mkinderwater/mk-piclock-kid/(list of files, cad)

Other CAD files:
mk-piclock-kids-v3_47-recess-roof-fix-6.scad
