mkinderwater/mk-piclock-kid/mk-piclock.c

/*
  mk-piclock.c

  Private Raspberry Pi alarm clock core daemon.

  Features:
    - SSD1322 256x64 OLED over /dev/spidev0.0
    - libgpiod GPIO for OLED DC/RST and TTP223B touch input
    - Private Unix socket control service for mk-piclock-api
    - MP3 playback using libmpg123 + ALSA PCM
    - Alarms, fonts, images, messages, bedtime dimming, touch input, and config

  Build both services with the supplied Makefile.
*/

#define _GNU_SOURCE

#include <ctype.h>
#include <errno.h>
#include <dirent.h>
#include <fcntl.h>
#include <arpa/inet.h>
#include <net/if.h>
#include <linux/wireless.h>
#include <linux/spi/spidev.h>
#include <poll.h>
#include <pwd.h>
#include <alsa/asoundlib.h>
#include <mpg123.h>
#include <pthread.h>
#include <signal.h>
#include <stdarg.h>
#include <stdint.h>
#include <stdio.h>
#include <stdlib.h>
#include <string.h>
#include <sys/ioctl.h>
#include <sys/socket.h>
#include <sys/stat.h>
#include <sys/types.h>
#include <sys/un.h>
#include <time.h>
#include <unistd.h>

#include <ft2build.h>
#include FT_FREETYPE_H

#include <gpiod.h>

#include "hardware_profile.h"
#include "ipc_protocol.h"
#include "led_control.h"
#include "asset_format.h"
#include "font_catalog.h"
#include "util.h"

#define safe_str mp_safe_str
#define write_all mp_write_full

#define APP_NAME "mk-piclock-core"
#define APP_VERSION MP_PRODUCT_VERSION

#define LED_PROFILE(fx, level, seconds, r1, g1, b1, r2, g2, b2) \
    { .effect = (fx), .brightness = (level), .cycle_seconds = (seconds), .reserved = 0, \
      .red1 = (r1), .green1 = (g1), .blue1 = (b1), \
      .red2 = (r2), .green2 = (g2), .blue2 = (b2) }
#define DEFAULT_CLOCK_NAME "Rylie"
#define STARTUP_GREETING_SECONDS 3
#define APP_ROOT "/opt/mk-piclock"
#define IMAGE_DIR APP_ROOT "/assets/images"
#define BEDTIME_IMAGE_DIR APP_ROOT "/assets/bedtime-images"
#define MUSIC_DIR APP_ROOT "/assets/music"
#define STORY_DIR APP_ROOT "/assets/stories"
#define DEFAULT_ALARM_PATH APP_ROOT "/assets/default-alarm.mp3"
#define DEFAULT_ALARM_LABEL "Built-in Alarm"
#define MESSAGE_CHIME_PATH APP_ROOT "/assets/message-chime.mp3"
#define MESSAGE_CHIME_LABEL "Message Chime"
#define MESSAGE_CHIME_VOLUME_MAX 55
#define ALARM_MAX_DURATION_SECONDS 1800
#define FONT_DIR APP_ROOT "/assets/fonts"
#define SYSTEM_DEFAULT_FONT_ID 4
#define LEGACY_SYSTEM_DEFAULT_FONT_KEY "system-dejavu-sans-mono"
#define SYSTEM_DEFAULT_FONT_PATH "/usr/share/fonts/truetype/dejavu/DejaVuSansMono.ttf"
#define CONFIG_DIR APP_ROOT "/config"
#define CONFIG_FILE CONFIG_DIR "/clock.conf"
#define LOG_FILE CONFIG_DIR "/event.log"
#define LOG_MAX_BYTES 65536
#define LOG_KEEP_BYTES 32768
#define LOG_VIEW_LINES 200


#define OLED_SPI_DEV "/dev/spidev0.0"
#define OLED_W 256
#define OLED_H 64
#define OLED_ROW_BYTES (OLED_W / 2)
#define OLED_FB_BYTES ((OLED_W * OLED_H) / 2)
#define OLED_EDGE_PADDING 2
#define SPI_SPEED_HZ 4000000
#define SPI_CHUNK 4096

#define MESSAGE_IMAGE_X OLED_EDGE_PADDING
#define MESSAGE_IMAGE_Y 8
#define MESSAGE_IMAGE_WIDTH 96
#define MESSAGE_IMAGE_HEIGHT 48
#define MESSAGE_IMAGE_TEXT_GAP 8
#define MESSAGE_TEXT_RIGHT_PADDING 6
#define MESSAGE_TEXT_X (MESSAGE_IMAGE_X + MESSAGE_IMAGE_WIDTH + MESSAGE_IMAGE_TEXT_GAP)
#define MESSAGE_TEXT_Y 8
#define MESSAGE_TEXT_W (OLED_W - MESSAGE_TEXT_X - MESSAGE_TEXT_RIGHT_PADDING)
#define MESSAGE_TEXT_H 48
#define MESSAGE_MAX_LINES 3
#define MESSAGE_LINE_CHARS 64
#define MESSAGE_INPUT_MAX_CHARS 180
#define MESSAGE_FALLBACK_SCALE 1
#define MESSAGE_TTF_MIN_PX 9
#define MESSAGE_TTF_MAX_PX 12
#define MESSAGE_DEFAULT_DURATION_SECONDS 30
#define MESSAGE_DELAY_MAX_SECONDS 60


#define GPIO_CHIP "/dev/gpiochip0"
#define GPIO_DC 25
#define GPIO_RST 27
#define GPIO_TOUCH 20
#define TOUCH_POLL_MS 20u
#define TOUCH_DEBOUNCE_MS 50u
#define TOUCH_LONG_PRESS_MS 3000u
#define TOUCH_DIAGNOSTIC_PRESS_MS 8000u
#define DIAGNOSTIC_SCREEN_SECONDS 30u
#define DIAGNOSTIC_REFRESH_MS 2000u
#define STORY_PRESS_COUNT 10
#define STORY_PRESS_WINDOW_MS 8000u
#define STORY_MESSAGE_MAX 64
#define STORY_COLLAGE_MAX_IMAGES 5
#define STORY_COLLAGE_IMAGE_SIZE 48
#define STORY_INTRO_SECONDS 3u
#define STORY_TITLE_SECONDS 4u

#define MAX_ALARMS 7
#define MUSIC_FILE_MAX 256
#define IMAGE_FILE_MAX 128
#define CLOCK_IMAGE_CHANGE_MAX_SECONDS 300
#define BEDTIME_IMAGE_CHANGE_SECONDS 300
#define CLOCK_TIME_Y_OFFSET -7
#define CLOCK_FOOTER_H 11
#define CLOCK_FOOTER_TEXT_Y (OLED_H - 9)
#define CLOCK_EDGE_PADDING OLED_EDGE_PADDING
#define CLOCK_CONTENT_RIGHT_PIXEL (OLED_W - CLOCK_EDGE_PADDING - 1)
#define CLOCK_SECONDS_LINE_Y (OLED_H - CLOCK_FOOTER_H - 1)
#define CLOCK_SECONDS_LINE_LEVEL 12
#define CLOCK_STATUS_TEXT_X CLOCK_EDGE_PADDING
#define CLOCK_IMAGE_X CLOCK_STATUS_TEXT_X
#define CLOCK_IMAGE_Y CLOCK_EDGE_PADDING
#define CLOCK_IMAGE_MAX_WIDTH 96
#define CLOCK_IMAGE_BOTTOM_PIXEL (CLOCK_SECONDS_LINE_Y - CLOCK_EDGE_PADDING - 1)
#define CLOCK_IMAGE_HEIGHT (CLOCK_IMAGE_BOTTOM_PIXEL - CLOCK_IMAGE_Y + 1)
#define CLOCK_IMAGE_FONT_GAP CLOCK_EDGE_PADDING
#define CLOCK_STATUS_CONTENT_GAP 7
#define SONG_METADATA_TEXT_MAX (MP_ID3_TEXT_MAX * 2 + 4)
#define SONG_SCROLL_SPEED_PX_PER_SEC 18u
#define SONG_SCROLL_GAP_PX 24
#define SONG_SCROLL_FRAME_US 75000u

#if CLOCK_STATUS_TEXT_X != CLOCK_EDGE_PADDING
#error "Alarm footer left padding must use CLOCK_EDGE_PADDING"
#endif
#if CLOCK_IMAGE_X != CLOCK_STATUS_TEXT_X
#error "Clock artwork and ALARM text must share the same left pixel"
#endif
#if MESSAGE_IMAGE_X != CLOCK_STATUS_TEXT_X
#error "Message artwork and ALARM text must share the same left pixel"
#endif
#if MESSAGE_IMAGE_X != CLOCK_IMAGE_X || MESSAGE_IMAGE_Y != 8
#error "Message artwork must preserve X=2 alignment and Y=8 placement"
#endif
#if MESSAGE_IMAGE_WIDTH != CLOCK_IMAGE_MAX_WIDTH || MESSAGE_IMAGE_HEIGHT != CLOCK_IMAGE_HEIGHT
#error "Message artwork must preserve the normal 96x48 clock image viewport"
#endif
#if MESSAGE_TEXT_X != 106 || MESSAGE_TEXT_Y != 8 || MESSAGE_TEXT_W != 144 || MESSAGE_TEXT_H != 48
#error "Message text viewport must remain 144x48 at X=106, Y=8"
#endif
#if MESSAGE_TTF_MIN_PX != 9 || MESSAGE_TTF_MAX_PX != 12 || MESSAGE_FALLBACK_SCALE != 1
#error "Message typography must remain independent and compact"
#endif


#define CORE_RUNTIME_DIR "/run/mk-piclock"
#define CORE_SOCKET_PATH CORE_RUNTIME_DIR "/core.sock"
#define ASSET_LIST_MAX_FILES 256
#define ASSET_LIST_NAME_MAX MUSIC_FILE_MAX

static volatile sig_atomic_t g_running = 1;
static time_t g_start_time = 0;
static pthread_mutex_t g_log_lock = PTHREAD_MUTEX_INITIALIZER;
static char g_footer_alarm_label[32] = "";
static int g_footer_content_min_x = CLOCK_STATUS_TEXT_X;

struct clock_tick_cache {
    uint8_t colon_off_fb[OLED_FB_BYTES];
    uint8_t colon_on_fb[OLED_FB_BYTES];
    int valid;
};

static struct clock_tick_cache g_clock_tick_cache = {
    .valid = 0
};

struct rotating_image_state {
    char file[IMAGE_FILE_MAX];
    time_t next_change;
};

static struct rotating_image_state g_rotating_images[2];

struct story_collage_state {
    char files[STORY_COLLAGE_MAX_IMAGES][IMAGE_FILE_MAX];
    int count;
};

static struct story_collage_state g_story_collage;

struct image_raw_cache {
    char file[IMAGE_FILE_MAX];
    int bedtime;
    uint8_t raw[MP_IMAGE_RAW_BYTES];
    int valid;
    unsigned long generation;
};

static pthread_mutex_t g_image_raw_cache_lock = PTHREAD_MUTEX_INITIALIZER;
static struct image_raw_cache g_image_raw_cache = { .file = "", .bedtime = 0, .valid = 0, .generation = 0 };

struct alarm_slot {
    int enabled;
    int hour;
    int min;
    int weekdays;          /* bit 0 Sunday through bit 6 Saturday */
    int start_volume;      /* 0..100 */
    int end_volume;        /* 0..100 */
    int last_fired_date;   /* local YYYYMMDD, persisted before playback starts */
    char music_file[MUSIC_FILE_MAX]; /* empty = random uploaded MP3 */
};

static time_t next_alarm_time(const struct alarm_slot alarms[MAX_ALARMS], time_t now,
                              int *alarm_id);

struct app_state {
    int display_mode;       /* 0 clock, 1 clear, 2 message, 3 diagnostics */
    int display_dirty;      /* set by API IPC thread; drawn by main OLED loop */
    int diagnostic_return_mode;
    time_t diagnostic_until;
    char message_image_file[IMAGE_FILE_MAX];
    int message_image_bedtime;
    time_t message_until;   /* unix time; 0 = no active message */
    char message_text[192];
    char pending_message_image_file[IMAGE_FILE_MAX];
    int pending_message_image_bedtime;
    int pending_message_notification_sound;
    char pending_message_text[192];
    time_t pending_message_at;
    int global_volume;
    int story_mode_enabled;
    int story_volume;
    char story_message[STORY_MESSAGE_MAX];
    int story_playing;
    uint64_t story_intro_until_ms;
    uint64_t story_title_until_ms;
    int bedtime_enabled;
    int bedtime_start_hour;
    int bedtime_start_min;
    int bedtime_end_hour;
    int bedtime_end_min;
    int bedtime_dim_percent;
    int bedtime_music_enabled;
    int oled_contrast_current;
    int oled_master_current;
    int oled_brightness_current;
    int brightness_preview_percent;
    time_t brightness_preview_until;
    int audio_playing;
    char audio_file[MUSIC_FILE_MAX];
    char audio_title[MP_ID3_TEXT_MAX];
    char audio_artist[MP_ID3_TEXT_MAX];
    char audio_display[SONG_METADATA_TEXT_MAX];
    uint64_t audio_scroll_started_ms;
    int show_song_metadata;
    int alarm_active;             /* 1 only while an alarm MP3 is currently playing */
    int alarm_volume_percent;     /* current alarm ramp volume, 0..100 */
    long long last_successful_alarm;
    int alarm_replay_guard_migrated;
    struct alarm_slot alarms[MAX_ALARMS];
    struct mp_led_profile led_profiles[MP_LED_SCENE_COUNT];
    struct mp_led_global_settings led_settings;
    int led_bedtime_fade_active;
    int led_preview_scene;
    time_t led_preview_until;
    int led_preview_bypass_master;
    int led_preview_raw_output;
    struct mp_led_profile led_preview_profile;
    int oled_ok;
    char clock_name[64];
    int oled_font;         /* 0 seven, 1 seven thin, 2 pixel, 3 pixel bold, 4 Linux default */
    char oled_font_file[128]; /* uploaded filename or system font key, empty = built-in */
    int oled_font_size;    /* TrueType pixel size */
    int clock_24h_mode;    /* 0 = 12-hour, 1 = 24-hour */
    int oled_color;        /* GUI panel colour: yellow, green, or white */
    pthread_mutex_t lock;
};

static struct app_state g_state = {
    .display_mode = 0,
    .display_dirty = 1,
    .diagnostic_return_mode = 0,
    .diagnostic_until = 0,
    .message_image_file = "",
    .message_image_bedtime = 0,
    .message_until = 0,
    .message_text = "",
    .pending_message_image_file = "",
    .pending_message_image_bedtime = 0,
    .pending_message_notification_sound = 0,
    .pending_message_text = "",
    .pending_message_at = 0,
    .global_volume = 80,
    .story_mode_enabled = 0,
    .story_volume = 55,
    .story_message = "STORY MODE!",
    .story_playing = 0,
    .story_intro_until_ms = 0,
    .story_title_until_ms = 0,
    .bedtime_enabled = 0,
    .bedtime_start_hour = 21,
    .bedtime_start_min = 0,
    .bedtime_end_hour = 7,
    .bedtime_end_min = 0,
    .bedtime_dim_percent = 35,
    .bedtime_music_enabled = 1,
    .oled_contrast_current = -1,
    .oled_master_current = -1,
    .oled_brightness_current = -1,
    .brightness_preview_percent = -1,
    .brightness_preview_until = 0,
    .audio_playing = 0,
    .audio_file = "",
    .audio_title = "",
    .audio_artist = "",
    .audio_display = "",
    .audio_scroll_started_ms = 0,
    .show_song_metadata = 1,
    .alarm_active = 0,
    .alarm_volume_percent = 0,
    .last_successful_alarm = 0,
    .alarm_replay_guard_migrated = 0,
    .led_profiles = {
        [MP_LED_SCENE_ALARM] = LED_PROFILE(MP_LED_EFFECT_FADE, 70, 8, 255, 0, 0, 255, 160, 0),
        [MP_LED_SCENE_BEDTIME] = LED_PROFILE(MP_LED_EFFECT_SOLID, 3, 8, 255, 48, 0, 255, 48, 0),
        [MP_LED_SCENE_MESSAGE] = LED_PROFILE(MP_LED_EFFECT_FADE, 35, 8, 0, 150, 255, 255, 255, 255),
        [MP_LED_SCENE_MUSIC] = LED_PROFILE(MP_LED_EFFECT_RAINBOW, 40, 12, 255, 0, 0, 0, 0, 255),
        [MP_LED_SCENE_DAYTIME] = LED_PROFILE(MP_LED_EFFECT_SOLID, 5, 8, 255, 220, 160, 255, 220, 160),
        [MP_LED_SCENE_STORIES] = LED_PROFILE(MP_LED_EFFECT_FADE, 15, 8, 125, 45, 255, 0, 90, 255),
        [MP_LED_SCENE_TOUCH] = LED_PROFILE(MP_LED_EFFECT_FADE, 60, 2, 255, 255, 255, 0, 0, 0)
    },
    .led_settings = {1, 100, 100, 65, 80, 0, 15, 1, 60, 255, 255, 255},
    .led_bedtime_fade_active = 0,
    .led_preview_scene = -1,
    .led_preview_until = 0,
    .led_preview_bypass_master = 0,
    .led_preview_raw_output = 0,
    .led_preview_profile = {0},
    .oled_ok = 0,
    .clock_name = DEFAULT_CLOCK_NAME,
    .oled_font = SYSTEM_DEFAULT_FONT_ID,
    .oled_font_file = "",
    .oled_font_size = 48,
    .clock_24h_mode = 0,
    .oled_color = MP_OLED_COLOR_GREEN,
    .lock = PTHREAD_MUTEX_INITIALIZER
};

struct font_cache_state {
    pthread_mutex_t lock;
    FT_Library library;
    FT_Face face;
    char loaded_file[128];
    int loaded_size;
};

static struct font_cache_state g_font = {
    .lock = PTHREAD_MUTEX_INITIALIZER,
    .library = NULL,
    .face = NULL,
    .loaded_file = "",
    .loaded_size = 0
};

struct audio_player_state {
    pthread_mutex_t lock;
    pthread_cond_t stopped;
    int running;
    int stop_requested;
    int alarm_mode;
    int notification_mode;
    int timed_out;
    uint64_t alarm_deadline_ms;
    char file[MUSIC_FILE_MAX];
};

static struct audio_player_state g_audio = {
    .lock = PTHREAD_MUTEX_INITIALIZER,
    .stopped = PTHREAD_COND_INITIALIZER,
    .running = 0,
    .stop_requested = 0,
    .alarm_mode = 0,
    .notification_mode = 0,
    .timed_out = 0,
    .alarm_deadline_ms = 0,
    .file = ""
};


struct oled_dev {
    int spi_fd;
    struct gpiod_chip *chip;
    struct gpiod_line_request *gpio_req;
    uint8_t fb[OLED_FB_BYTES];
    uint8_t prev_fb[OLED_FB_BYTES];
    uint8_t preview_fb[OLED_FB_BYTES];
    pthread_mutex_t preview_lock;
    int prev_valid;
};

static struct oled_dev g_oled = {
    .spi_fd = -1,
    .chip = NULL,
    .gpio_req = NULL,
    .preview_lock = PTHREAD_MUTEX_INITIALIZER,
    .prev_valid = 0
};

/* Drawing normally targets the physical OLED framebuffer. The message editor
 * can render into a thread-local scratch framebuffer so its browser preview is
 * produced by the exact same renderer without changing the physical screen. */
static _Thread_local uint8_t *g_oled_render_fb = NULL;

static uint8_t *oled_draw_fb(void) {
    return g_oled_render_fb ? g_oled_render_fb : g_oled.fb;
}

struct touch_dev {
    struct gpiod_chip *chip;
    struct gpiod_line_request *request;
    pthread_mutex_t lock;
    int ready;
    int pressed;
};

static struct touch_dev g_touch = {
    .chip = NULL,
    .request = NULL,
    .lock = PTHREAD_MUTEX_INITIALIZER,
    .ready = 0,
    .pressed = 0
};

static void touch_get_state(int *ready, int *pressed);

static void on_signal(int sig) {
    (void)sig;
    g_running = 0;
}

static int ensure_dir(const char *path) {
    char tmp[512];
    snprintf(tmp, sizeof(tmp), "%s", path);
    size_t len = strlen(tmp);
    if (len == 0) return -1;
    if (tmp[len - 1] == '/') tmp[len - 1] = '\0';

    for (char *p = tmp + 1; *p; p++) {
        if (*p == '/') {
            *p = '\0';
            mkdir(tmp, 0755);
            *p = '/';
        }
    }
    if (mkdir(tmp, 0755) != 0 && errno != EEXIST) return -1;
    return 0;
}

static int hex_value(char ch) {
    if (ch >= '0' && ch <= '9') return ch - '0';
    if (ch >= 'a' && ch <= 'f') return ch - 'a' + 10;
    if (ch >= 'A' && ch <= 'F') return ch - 'A' + 10;
    return -1;
}

static void config_encode_to_buffer(char *out, size_t out_len, const char *in) {
    static const char hex[] = "0123456789ABCDEF";
    if (!out || out_len == 0) return;
    out[0] = '\0';
    if (!in) in = "";

    size_t j = 0;
    for (const unsigned char *p = (const unsigned char *)in; *p && j + 1 < out_len; p++) {
        unsigned char ch = *p;
        int plain = isalnum(ch) || ch == '.' || ch == '_' || ch == '-';
        if (plain) {
            out[j++] = (char)ch;
        } else {
            if (j + 3 >= out_len) break;
            out[j++] = '%';
            out[j++] = hex[(ch >> 4) & 0x0F];
            out[j++] = hex[ch & 0x0F];
        }
    }
    out[j] = '\0';
}

static void config_decode_inplace(char *s) {
    if (!s) return;
    char *o = s;
    for (char *p = s; *p; p++) {
        if (*p == '%' && p[1] && p[2]) {
            int hi = hex_value(p[1]);
            int lo = hex_value(p[2]);
            if (hi >= 0 && lo >= 0) {
                *o++ = (char)((hi << 4) | lo);
                p += 2;
                continue;
            }
        }
        *o++ = *p;
    }
    *o = '\0';
}

static void log_trim_if_needed_locked(void) {
    struct stat st;
    if (stat(LOG_FILE, &st) != 0 || st.st_size <= LOG_MAX_BYTES) return;

    FILE *in = fopen(LOG_FILE, "rb");
    if (!in) return;

    long keep = LOG_KEEP_BYTES;
    if (st.st_size < keep) keep = (long)st.st_size;
    if (fseek(in, -keep, SEEK_END) != 0) {
        fclose(in);
        return;
    }

    char *buf = (char *)malloc((size_t)keep + 1);
    if (!buf) {
        fclose(in);
        return;
    }

    size_t got = fread(buf, 1, (size_t)keep, in);
    fclose(in);
    buf[got] = '\0';

    char *start = buf;
    if (got == (size_t)keep && st.st_size > keep) {
        char *nl = strchr(buf, '\n');
        if (nl && nl[1]) start = nl + 1;
    }

    char tmp_path[512];
    snprintf(tmp_path, sizeof(tmp_path), "%s.tmp", LOG_FILE);
    FILE *out = fopen(tmp_path, "wb");
    if (out) {
        fwrite(start, 1, strlen(start), out);
        fclose(out);
        rename(tmp_path, LOG_FILE);
    }
    free(buf);
}

static void app_log(const char *category, const char *fmt, ...) {
    char msg[512];
    va_list ap;
    va_start(ap, fmt);
    vsnprintf(msg, sizeof(msg), fmt, ap);
    va_end(ap);

    for (char *p = msg; *p; p++) {
        if (*p == '\r' || *p == '\n' || *p == '\t') *p = ' ';
    }

    time_t now = time(NULL);
    struct tm tmv;
    localtime_r(&now, &tmv);
    char ts[32];
    strftime(ts, sizeof(ts), "%Y-%m-%d %H:%M:%S", &tmv);

    pthread_mutex_lock(&g_log_lock);
    ensure_dir(CONFIG_DIR);
    log_trim_if_needed_locked();

    FILE *f = fopen(LOG_FILE, "a");
    if (f) {
        fprintf(f, "%s [%s] %s\n", ts, category && *category ? category : "info", msg);
        fclose(f);
    }
    pthread_mutex_unlock(&g_log_lock);
}

static void sanitize_clock_name(char *s) {
    if (!s) return;

    char out[64];
    size_t j = 0;
    int last_space = 1;

    for (const unsigned char *p = (const unsigned char *)s; *p && j + 1 < sizeof(out); p++) {
        unsigned char ch = *p;
        if (ch == '\r' || ch == '\n' || ch == '\t') ch = ' ';
        if (ch < 32 || ch > 126) continue;
        if (ch == '<' || ch == '>' || ch == '&' || ch == '"') continue;
        if (ch == ' ') {
            if (last_space) continue;
            last_space = 1;
        } else {
            last_space = 0;
        }
        out[j++] = (char)ch;
    }

    while (j > 0 && out[j - 1] == ' ') j--;
    out[j] = '\0';

    if (!out[0]) snprintf(out, sizeof(out), "%s", DEFAULT_CLOCK_NAME);
    safe_str(s, 64, out);
}

static int safe_asset_filename(const char *name);
static void sanitize_message_text(char *s, size_t s_len);


static int has_raw_ext(const char *name) {
    const char *dot = strrchr(name ? name : "", '.');
    return dot && strcasecmp(dot, ".raw") == 0;
}

static int safe_image_filename(const char *name) {
    return safe_asset_filename(name) && has_raw_ext(name);
}

static const char *image_dir(int bedtime) {
    return bedtime ? BEDTIME_IMAGE_DIR : IMAGE_DIR;
}

static int make_image_path_by_file(const char *file, int bedtime, char *out, size_t out_len) {
    if (!out || out_len == 0) return -1;
    out[0] = '\0';
    if (!safe_image_filename(file)) return -1;
    int written = snprintf(out, out_len, "%s/%s", image_dir(bedtime), file);
    return written > 0 && (size_t)written < out_len ? 0 : -1;
}

static int has_font_ext(const char *name) {
    const char *dot = strrchr(name ? name : "", '.');
    if (!dot) return 0;
    return strcasecmp(dot, ".ttf") == 0 || strcasecmp(dot, ".otf") == 0;
}

static int safe_asset_filename(const char *name) {
    if (!name || !*name || strlen(name) >= 120) return 0;
    if (strcmp(name, ".") == 0 || strcmp(name, "..") == 0) return 0;
    for (const char *p = name; *p; p++) {
        unsigned char ch = (unsigned char)*p;
        if (!(isalnum(ch) || ch == '.' || ch == '_' || ch == '-')) return 0;
    }
    return 1;
}

static void make_font_path(const char *file, char *out, size_t out_len) {
    if (!out || out_len == 0) return;
    out[0] = '\0';
    if (file && strcmp(file, LEGACY_SYSTEM_DEFAULT_FONT_KEY) == 0) {
        safe_str(out, out_len, SYSTEM_DEFAULT_FONT_PATH);
        return;
    }
    if (mp_system_font_is_key(file)) {
        (void)mp_system_font_resolve(file, out, out_len);
        return;
    }
    snprintf(out, out_len, FONT_DIR "/%s", file && *file ? file : "");
}

static int clamp_int(int v, int lo, int hi) {
    if (v < lo) return lo;
    if (v > hi) return hi;
    return v;
}

static int local_date_key(const struct tm *tmv) {
    if (!tmv) return 0;
    int year = tmv->tm_year + 1900;
    int month = tmv->tm_mon + 1;
    if (year < 1970 || year > 9999 || month < 1 || month > 12 ||
        tmv->tm_mday < 1 || tmv->tm_mday > 31) return 0;
    return year * 10000 + month * 100 + tmv->tm_mday;
}

static int has_mp3_ext(const char *name) {
    if (!name) return 0;
    const char *dot = strrchr(name, '.');
    return dot && strcasecmp(dot, ".mp3") == 0;
}

static void make_music_path(const char *file, char *out, size_t out_len) {
    snprintf(out, out_len, MUSIC_DIR "/%s", file && *file ? file : "");
}


enum asset_list_kind {
    ASSET_LIST_IMAGE_RAW = 1,
    ASSET_LIST_MUSIC_MP3 = 2,
    ASSET_LIST_FONT = 3
};

static void invalidate_image_raw_cache(void) {
    pthread_mutex_lock(&g_image_raw_cache_lock);
    g_image_raw_cache.valid = 0;
    g_image_raw_cache.file[0] = '\0';
    g_image_raw_cache.generation++;
    pthread_mutex_unlock(&g_image_raw_cache_lock);
}

static void invalidate_image_assets(int bedtime) {
    invalidate_image_raw_cache();
    struct rotating_image_state *state = &g_rotating_images[bedtime ? 1 : 0];
    state->file[0] = '\0';
    state->next_change = 0;
}


static int asset_file_matches_kind(const char *dir, const char *name, int kind) {
    if (!dir || !name) return 0;
    if (kind == ASSET_LIST_IMAGE_RAW) {
        if (!safe_image_filename(name)) return 0;
        char path[512];
        snprintf(path, sizeof(path), "%s/%s", dir, name);
        struct stat st;
        return stat(path, &st) == 0 && MP_IMAGE_RAW_SIZE_VALID(st.st_size);
    }
    if (!safe_asset_filename(name)) return 0;
    if (kind == ASSET_LIST_MUSIC_MP3) return has_mp3_ext(name);
    if (kind == ASSET_LIST_FONT) return has_font_ext(name);
    return 0;
}

static int scan_asset_files(const char *dir, int kind, char files[][ASSET_LIST_NAME_MAX], int max_files) {
    if (!dir || !files || max_files <= 0) return 0;
    DIR *d = opendir(dir);
    if (!d) return 0;
    int count = 0;
    struct dirent *de;
    while ((de = readdir(d)) != NULL && count < max_files) {
        if (!asset_file_matches_kind(dir, de->d_name, kind)) continue;
        safe_str(files[count++], ASSET_LIST_NAME_MAX, de->d_name);
    }
    closedir(d);
    for (int i = 0; i < count; i++) {
        for (int j = i + 1; j < count; j++) {
            if (strcasecmp(files[i], files[j]) > 0) {
                char tmp[ASSET_LIST_NAME_MAX];
                safe_str(tmp, sizeof(tmp), files[i]);
                safe_str(files[i], ASSET_LIST_NAME_MAX, files[j]);
                safe_str(files[j], ASSET_LIST_NAME_MAX, tmp);
            }
        }
    }
    return count;
}

static int apply_default_font_selection(void) {
    char current[sizeof(g_state.oled_font_file)];
    int builtin;
    pthread_mutex_lock(&g_state.lock);
    safe_str(current, sizeof(current), g_state.oled_font_file);
    builtin = g_state.oled_font;
    pthread_mutex_unlock(&g_state.lock);

    int current_valid = 0;
    if (current[0] && strcmp(current, LEGACY_SYSTEM_DEFAULT_FONT_KEY) != 0) {
        char path[MP_SYSTEM_FONT_PATH_MAX];
        make_font_path(current, path, sizeof(path));
        current_valid = path[0] && access(path, R_OK) == 0;
    }
    if (current_valid || (!current[0] && builtin != SYSTEM_DEFAULT_FONT_ID)) return 0;

    char candidate[sizeof(g_state.oled_font_file)] = "";
    char files[ASSET_LIST_MAX_FILES][ASSET_LIST_NAME_MAX];
    int uploaded_count = scan_asset_files(FONT_DIR, ASSET_LIST_FONT, files, ASSET_LIST_MAX_FILES);
    if (uploaded_count > 0) {
        safe_str(candidate, sizeof(candidate), files[0]);
    } else {
        char system_path[MP_SYSTEM_FONT_PATH_MAX];
        (void)mp_system_font_find_filename("DejaVuSansMono.ttf", candidate, sizeof(candidate),
                                           system_path, sizeof(system_path));
    }

    int changed = 0;
    pthread_mutex_lock(&g_state.lock);
    if (strcmp(g_state.oled_font_file, current) == 0 && g_state.oled_font == builtin) {
        if (strcmp(g_state.oled_font_file, candidate) != 0 ||
            g_state.oled_font != SYSTEM_DEFAULT_FONT_ID) {
            safe_str(g_state.oled_font_file, sizeof(g_state.oled_font_file), candidate);
            g_state.oled_font = SYSTEM_DEFAULT_FONT_ID;
            g_state.display_dirty = 1;
            changed = 1;
        }
    }
    pthread_mutex_unlock(&g_state.lock);
    return changed;
}

static void init_alarm_defaults(void) {
    for (int i = 0; i < MAX_ALARMS; i++) {
        g_state.alarms[i].enabled = 0;
        g_state.alarms[i].hour = 7;
        g_state.alarms[i].min = 0;
        g_state.alarms[i].weekdays = 0x7F;
        g_state.alarms[i].start_volume = 20;
        g_state.alarms[i].end_volume = 80;
        g_state.alarms[i].last_fired_date = 0;
        g_state.alarms[i].music_file[0] = '\0';
    }
}


static void reset_persistent_state_locked(void) {
    g_state.display_mode = 0;
    g_state.display_dirty = 1;
    g_state.diagnostic_return_mode = 0;
    g_state.diagnostic_until = 0;
    g_state.message_image_file[0] = '\0';
    g_state.message_image_bedtime = 0;
    g_state.message_until = 0;
    g_state.message_text[0] = '\0';
    g_state.pending_message_image_file[0] = '\0';
    g_state.pending_message_image_bedtime = 0;
    g_state.pending_message_notification_sound = 0;
    g_state.pending_message_text[0] = '\0';
    g_state.pending_message_at = 0;
    g_state.global_volume = 80;
    g_state.story_mode_enabled = 0;
    g_state.story_volume = 55;
    safe_str(g_state.story_message, sizeof(g_state.story_message), "STORY MODE!");
    g_state.story_playing = 0;
    g_state.story_intro_until_ms = 0;
    g_state.story_title_until_ms = 0;
    g_state.bedtime_enabled = 0;
    g_state.bedtime_start_hour = 21;
    g_state.bedtime_start_min = 0;
    g_state.bedtime_end_hour = 7;
    g_state.bedtime_end_min = 0;
    g_state.bedtime_dim_percent = 35;
    g_state.bedtime_music_enabled = 1;
    g_state.show_song_metadata = 1;
    g_state.last_successful_alarm = 0;
    g_state.alarm_replay_guard_migrated = 1;
    safe_str(g_state.clock_name, sizeof(g_state.clock_name), DEFAULT_CLOCK_NAME);
    g_state.oled_font = SYSTEM_DEFAULT_FONT_ID;
    g_state.oled_font_file[0] = '\0';
    g_state.oled_font_size = 48;
    g_state.clock_24h_mode = 0;
    g_state.oled_color = MP_OLED_COLOR_GREEN;
    g_state.led_profiles[MP_LED_SCENE_ALARM] =
        (struct mp_led_profile)LED_PROFILE(MP_LED_EFFECT_FADE, 70, 8, 255, 0, 0, 255, 160, 0);
    g_state.led_profiles[MP_LED_SCENE_BEDTIME] =
        (struct mp_led_profile)LED_PROFILE(MP_LED_EFFECT_SOLID, 3, 8, 255, 48, 0, 255, 48, 0);
    g_state.led_profiles[MP_LED_SCENE_MESSAGE] =
        (struct mp_led_profile)LED_PROFILE(MP_LED_EFFECT_FADE, 35, 8, 0, 150, 255, 255, 255, 255);
    g_state.led_profiles[MP_LED_SCENE_MUSIC] =
        (struct mp_led_profile)LED_PROFILE(MP_LED_EFFECT_RAINBOW, 40, 12, 255, 0, 0, 0, 0, 255);
    g_state.led_profiles[MP_LED_SCENE_DAYTIME] =
        (struct mp_led_profile)LED_PROFILE(MP_LED_EFFECT_SOLID, 5, 8, 255, 220, 160, 255, 220, 160);
    g_state.led_profiles[MP_LED_SCENE_STORIES] =
        (struct mp_led_profile)LED_PROFILE(MP_LED_EFFECT_FADE, 15, 8, 125, 45, 255, 0, 90, 255);
    g_state.led_profiles[MP_LED_SCENE_TOUCH] =
        (struct mp_led_profile)LED_PROFILE(MP_LED_EFFECT_FADE, 60, 2, 255, 255, 255, 0, 0, 0);
    g_state.led_settings =
        (struct mp_led_global_settings){1, 100, 100, 65, 80, 0, 15, 1, 60, 255, 255, 255};
    g_state.led_bedtime_fade_active = 0;
    g_state.led_preview_scene = -1;
    g_state.led_preview_until = 0;
    g_state.led_preview_bypass_master = 0;
    g_state.led_preview_raw_output = 0;
    memset(&g_state.led_preview_profile, 0, sizeof(g_state.led_preview_profile));
    for (int i = 0; i < MAX_ALARMS; i++) {
        g_state.alarms[i].enabled = 0;
        g_state.alarms[i].hour = 7;
        g_state.alarms[i].min = 0;
        g_state.alarms[i].weekdays = 0x7F;
        g_state.alarms[i].start_volume = 20;
        g_state.alarms[i].end_volume = 80;
        g_state.alarms[i].last_fired_date = 0;
        g_state.alarms[i].music_file[0] = '\0';
    }
}


#define CONFIG_INT_FIELDS(X) \
    X("global_volume", g_state.global_volume, "%d") \
    X("story_mode_enabled", g_state.story_mode_enabled, "%d") \
    X("story_volume", g_state.story_volume, "%d") \
    X("show_song_metadata", g_state.show_song_metadata, "%d") \
    X("bedtime_enabled", g_state.bedtime_enabled, "%d") \
    X("bedtime_start_hour", g_state.bedtime_start_hour, "%02d") \
    X("bedtime_start_min", g_state.bedtime_start_min, "%02d") \
    X("bedtime_end_hour", g_state.bedtime_end_hour, "%02d") \
    X("bedtime_end_min", g_state.bedtime_end_min, "%02d") \
    X("bedtime_dim_percent", g_state.bedtime_dim_percent, "%d") \
    X("bedtime_music_enabled", g_state.bedtime_music_enabled, "%d") \
    X("oled_font", g_state.oled_font, "%d") \
    X("oled_font_size", g_state.oled_font_size, "%d") \
    X("clock_24h_mode", g_state.clock_24h_mode, "%d") \
    X("oled_color", g_state.oled_color, "%d") \
    X("alarm_replay_guard_migrated", g_state.alarm_replay_guard_migrated, "%d") \
    X("led_enabled", g_state.led_settings.enabled, "%d") \
    X("led_max_brightness", g_state.led_settings.max_brightness, "%d") \
    X("led_red_gain", g_state.led_settings.red_gain, "%d") \
    X("led_green_gain", g_state.led_settings.green_gain, "%d") \
    X("led_blue_gain", g_state.led_settings.blue_gain, "%d") \
    X("led_idle_off", g_state.led_settings.idle_off, "%d") \
    X("led_bedtime_fade_minutes", g_state.led_settings.bedtime_fade_minutes, "%d") \
    X("led_touch_blink_enabled", g_state.led_settings.touch_blink_enabled, "%d") \
    X("led_touch_blink_brightness", g_state.led_settings.touch_blink_brightness, "%d") \
    X("led_touch_blink_red", g_state.led_settings.touch_blink_red, "%d") \
    X("led_touch_blink_green", g_state.led_settings.touch_blink_green, "%d") \
    X("led_touch_blink_blue", g_state.led_settings.touch_blink_blue, "%d")

#define CONFIG_STRING_FIELDS(X) \
    X("clock_name", g_state.clock_name, sizeof(g_state.clock_name)) \
    X("story_message", g_state.story_message, sizeof(g_state.story_message)) \
    X("oled_font_file", g_state.oled_font_file, sizeof(g_state.oled_font_file))

#define CONFIG_ALARM_INT_FIELDS(X) \
    for (int i = 0; i < MAX_ALARMS; i++) { \
        X(i, "enabled", g_state.alarms[i].enabled, "%d", atoi(val) ? 1 : 0) \
        X(i, "hour", g_state.alarms[i].hour, "%02d", atoi(val)) \
        X(i, "min", g_state.alarms[i].min, "%02d", atoi(val)) \
        X(i, "weekdays", g_state.alarms[i].weekdays, "%d", atoi(val) & 0x7F) \
        X(i, "start_volume", g_state.alarms[i].start_volume, "%d", atoi(val)) \
        X(i, "end_volume", g_state.alarms[i].end_volume, "%d", atoi(val)) \
        X(i, "last_fired_date", g_state.alarms[i].last_fired_date, "%d", atoi(val)) \
    }

#define CONFIG_ALARM_STRING_FIELDS(X) \
    for (int i = 0; i < MAX_ALARMS; i++) { \
        X(i, "music_file", g_state.alarms[i].music_file, sizeof(g_state.alarms[i].music_file)) \
    }

static const char *led_scene_config_key(enum mp_led_scene scene) {
    switch (scene) {
        case MP_LED_SCENE_ALARM: return "alarm";
        case MP_LED_SCENE_BEDTIME: return "bedtime";
        case MP_LED_SCENE_MESSAGE: return "message";
        case MP_LED_SCENE_MUSIC: return "music";
        case MP_LED_SCENE_DAYTIME: return "daytime";
        case MP_LED_SCENE_STORIES: return "stories";
        case MP_LED_SCENE_TOUCH: return "touch";
        default: return "daytime";
    }
}

static void sanitize_led_profile(struct mp_led_profile *profile) {
    if (!profile) return;
    if (profile->effect > MP_LED_EFFECT_RAINBOW) profile->effect = MP_LED_EFFECT_SOLID;
    if (profile->brightness > 100) profile->brightness = 100;
    if (profile->cycle_seconds < 2) profile->cycle_seconds =
        profile->effect == MP_LED_EFFECT_RAINBOW ? 12 : 8;
    if (profile->cycle_seconds > 60) profile->cycle_seconds = 60;
    profile->reserved = 0;
}

static void sanitize_led_settings(struct mp_led_global_settings *settings) {
    if (!settings) return;
    settings->enabled = settings->enabled ? 1 : 0;
    if (settings->max_brightness > 100) settings->max_brightness = 100;
    if (settings->red_gain > 100) settings->red_gain = 100;
    if (settings->green_gain > 100) settings->green_gain = 100;
    if (settings->blue_gain > 100) settings->blue_gain = 100;
    settings->idle_off = settings->idle_off ? 1 : 0;
    if (settings->bedtime_fade_minutes > 120) settings->bedtime_fade_minutes = 120;
    settings->touch_blink_enabled = settings->touch_blink_enabled ? 1 : 0;
    if (settings->touch_blink_brightness > 100) settings->touch_blink_brightness = 100;
}

static int load_led_config_value(const char *key, const char *val) {
    char expected[96];
    for (int i = 0; i < MP_LED_SCENE_COUNT; i++) {
        struct mp_led_profile *profile = &g_state.led_profiles[i];
        const char *name = led_scene_config_key((enum mp_led_scene)i);
#define MATCH_LED_FIELD(suffix, target, maximum) \
        do { \
            snprintf(expected, sizeof(expected), "led_%s_%s", name, suffix); \
            if (strcmp(key, expected) == 0) { \
                target = (uint8_t)clamp_int(atoi(val), 0, maximum); \
                return 1; \
            } \
        } while (0)
        MATCH_LED_FIELD("effect", profile->effect, MP_LED_EFFECT_RAINBOW);
        MATCH_LED_FIELD("brightness", profile->brightness, 100);
        MATCH_LED_FIELD("cycle_seconds", profile->cycle_seconds, 60);
        MATCH_LED_FIELD("red1", profile->red1, 255);
        MATCH_LED_FIELD("green1", profile->green1, 255);
        MATCH_LED_FIELD("blue1", profile->blue1, 255);
        MATCH_LED_FIELD("red2", profile->red2, 255);
        MATCH_LED_FIELD("green2", profile->green2, 255);
        MATCH_LED_FIELD("blue2", profile->blue2, 255);
#undef MATCH_LED_FIELD
    }
    return 0;
}

static void save_config(void) {
    ensure_dir(CONFIG_DIR);

    char tmp_path[512];
    snprintf(tmp_path, sizeof(tmp_path), CONFIG_FILE ".tmp");

    FILE *f = fopen(tmp_path, "w");
    if (!f) return;

    pthread_mutex_lock(&g_state.lock);
#define SAVE_CONFIG_INT(cfg_key, field, fmt) fprintf(f, cfg_key "=" fmt "\n", field);
    CONFIG_INT_FIELDS(SAVE_CONFIG_INT)
#undef SAVE_CONFIG_INT
#define SAVE_CONFIG_ALARM_INT(idx, field_str, field, fmt, conversion) \
    fprintf(f, "alarm%d_%s=" fmt "\n", (idx) + 1, field_str, field);
    CONFIG_ALARM_INT_FIELDS(SAVE_CONFIG_ALARM_INT)
#undef SAVE_CONFIG_ALARM_INT
#define SAVE_CONFIG_ALARM_STRING(idx, field_str, field, field_size) \
    do { \
        char enc[(field_size) * 3]; \
        config_encode_to_buffer(enc, sizeof(enc), field); \
        fprintf(f, "alarm%d_%s=%s\n", (idx) + 1, field_str, enc); \
    } while (0);
    CONFIG_ALARM_STRING_FIELDS(SAVE_CONFIG_ALARM_STRING)
#undef SAVE_CONFIG_ALARM_STRING
#define SAVE_CONFIG_STRING(cfg_key, field, field_size) \
    do { \
        char enc[(field_size) * 3]; \
        config_encode_to_buffer(enc, sizeof(enc), field); \
        fprintf(f, cfg_key "=%s\n", enc); \
    } while (0);
    CONFIG_STRING_FIELDS(SAVE_CONFIG_STRING)
#undef SAVE_CONFIG_STRING
    for (int i = 0; i < MP_LED_SCENE_COUNT; i++) {
        const struct mp_led_profile *profile = &g_state.led_profiles[i];
        const char *name = led_scene_config_key((enum mp_led_scene)i);
        fprintf(f, "led_%s_effect=%u\n", name, profile->effect);
        fprintf(f, "led_%s_brightness=%u\n", name, profile->brightness);
        fprintf(f, "led_%s_cycle_seconds=%u\n", name, profile->cycle_seconds);
        fprintf(f, "led_%s_red1=%u\n", name, profile->red1);
        fprintf(f, "led_%s_green1=%u\n", name, profile->green1);
        fprintf(f, "led_%s_blue1=%u\n", name, profile->blue1);
        fprintf(f, "led_%s_red2=%u\n", name, profile->red2);
        fprintf(f, "led_%s_green2=%u\n", name, profile->green2);
        fprintf(f, "led_%s_blue2=%u\n", name, profile->blue2);
    }
    fprintf(f, "last_successful_alarm=%lld\n", g_state.last_successful_alarm);
    fprintf(f, "pending_message_at=%lld\n", (long long)g_state.pending_message_at);
    fprintf(f, "pending_message_image_bedtime=%d\n",
            g_state.pending_message_image_bedtime ? 1 : 0);
    fprintf(f, "pending_message_notification_sound=%d\n",
            g_state.pending_message_notification_sound ? 1 : 0);
    {
        char enc_image[sizeof(g_state.pending_message_image_file) * 3];
        char enc_text[sizeof(g_state.pending_message_text) * 3];
        config_encode_to_buffer(enc_image, sizeof(enc_image), g_state.pending_message_image_file);
        config_encode_to_buffer(enc_text, sizeof(enc_text), g_state.pending_message_text);
        fprintf(f, "pending_message_image_file=%s\n", enc_image);
        fprintf(f, "pending_message_text=%s\n", enc_text);
    }
    pthread_mutex_unlock(&g_state.lock);

    int ok = 1;
    if (fflush(f) != 0) ok = 0;
    if (ok && fsync(fileno(f)) != 0) ok = 0;
    if (fclose(f) != 0) ok = 0;

    if (ok) {
        if (rename(tmp_path, CONFIG_FILE) != 0) {
            unlink(tmp_path);
        } else {
            /* fsync the parent directory so the rename itself is durable before
               an alarm begins playing and power can be removed. */
            int dir_fd = open(CONFIG_DIR, O_RDONLY | O_DIRECTORY | O_CLOEXEC);
            if (dir_fd >= 0) {
                (void)fsync(dir_fd);
                close(dir_fd);
            }
        }
    } else {
        unlink(tmp_path);
    }
}

static void load_config(void) {
    FILE *f = fopen(CONFIG_FILE, "r");
    if (!f) return;

    char line[1024];
    while (fgets(line, sizeof(line), f)) {
        char *eq = strchr(line, '=');
        if (!eq) continue;
        *eq = '\0';
        char *key = line;
        char *val = eq + 1;
        val[strcspn(val, "\r\n")] = '\0';

        int matched = load_led_config_value(key, val);
        char tmp_key[128];
        if (!matched && strcmp(key, "last_successful_alarm") == 0) {
            char *end = NULL;
            errno = 0;
            long long parsed = strtoll(val, &end, 10);
            if (!errno && end != val && *end == '\0' && parsed > 0)
                g_state.last_successful_alarm = parsed;
            matched = 1;
        } else if (strcmp(key, "pending_message_at") == 0) {
            char *end = NULL;
            errno = 0;
            long long parsed = strtoll(val, &end, 10);
            if (!errno && end != val && *end == '\0' && parsed > 0)
                g_state.pending_message_at = (time_t)parsed;
            matched = 1;
        } else if (strcmp(key, "pending_message_image_bedtime") == 0) {
            g_state.pending_message_image_bedtime = atoi(val) ? 1 : 0;
            matched = 1;
        } else if (strcmp(key, "pending_message_notification_sound") == 0) {
            g_state.pending_message_notification_sound = atoi(val) ? 1 : 0;
            matched = 1;
        } else if (strcmp(key, "pending_message_image_file") == 0) {
            char decoded[384];
            safe_str(decoded, sizeof(decoded), val);
            config_decode_inplace(decoded);
            safe_str(g_state.pending_message_image_file, sizeof(g_state.pending_message_image_file), decoded);
            matched = 1;
        } else if (strcmp(key, "pending_message_text") == 0) {
            char decoded[768];
            safe_str(decoded, sizeof(decoded), val);
            config_decode_inplace(decoded);
            safe_str(g_state.pending_message_text, sizeof(g_state.pending_message_text), decoded);
            matched = 1;
        }
#define LOAD_CONFIG_ALARM_INT(idx, field_str, field, fmt, conversion) \
        do { \
            snprintf(tmp_key, sizeof(tmp_key), "alarm%d_%s", (idx) + 1, field_str); \
            if (!matched && strcmp(key, tmp_key) == 0) { \
                field = conversion; \
                matched = 1; \
            } \
        } while (0);
        CONFIG_ALARM_INT_FIELDS(LOAD_CONFIG_ALARM_INT)
#undef LOAD_CONFIG_ALARM_INT
#define LOAD_CONFIG_ALARM_STRING(idx, field_str, field, field_size) \
        do { \
            snprintf(tmp_key, sizeof(tmp_key), "alarm%d_%s", (idx) + 1, field_str); \
            if (!matched && strcmp(key, tmp_key) == 0) { \
                char dec[384]; \
                safe_str(dec, sizeof(dec), val); \
                config_decode_inplace(dec); \
                safe_str(field, field_size, dec); \
                matched = 1; \
            } \
        } while (0);
        CONFIG_ALARM_STRING_FIELDS(LOAD_CONFIG_ALARM_STRING)
#undef LOAD_CONFIG_ALARM_STRING

#define LOAD_CONFIG_INT(cfg_key, field, fmt) \
        do { \
            if (!matched && strcmp(key, cfg_key) == 0) { \
                field = atoi(val); \
                matched = 1; \
            } \
        } while (0);
        CONFIG_INT_FIELDS(LOAD_CONFIG_INT)
#undef LOAD_CONFIG_INT
#define LOAD_CONFIG_STRING(cfg_key, field, field_size) \
        do { \
            if (!matched && strcmp(key, cfg_key) == 0) { \
                char dec[384]; \
                safe_str(dec, sizeof(dec), val); \
                config_decode_inplace(dec); \
                safe_str(field, field_size, dec); \
                matched = 1; \
            } \
        } while (0);
        CONFIG_STRING_FIELDS(LOAD_CONFIG_STRING)
#undef LOAD_CONFIG_STRING
    }

    fclose(f);

    g_state.global_volume = clamp_int(g_state.global_volume, 0, 100);
    g_state.story_mode_enabled = g_state.story_mode_enabled ? 1 : 0;
    g_state.story_volume = clamp_int(g_state.story_volume, 0, 100);
    sanitize_message_text(g_state.story_message, sizeof(g_state.story_message));
    if (!g_state.story_message[0]) safe_str(g_state.story_message, sizeof(g_state.story_message), "STORY MODE!");
    g_state.show_song_metadata = g_state.show_song_metadata ? 1 : 0;
    g_state.bedtime_enabled = g_state.bedtime_enabled ? 1 : 0;
    g_state.bedtime_start_hour = clamp_int(g_state.bedtime_start_hour, 0, 23);
    g_state.bedtime_start_min = clamp_int(g_state.bedtime_start_min, 0, 59);
    g_state.bedtime_end_hour = clamp_int(g_state.bedtime_end_hour, 0, 23);
    g_state.bedtime_end_min = clamp_int(g_state.bedtime_end_min, 0, 59);
    g_state.bedtime_dim_percent = clamp_int(g_state.bedtime_dim_percent, 0, 100);
    g_state.bedtime_music_enabled = g_state.bedtime_music_enabled ? 1 : 0;
    if (g_state.last_successful_alarm < 0) g_state.last_successful_alarm = 0;
    g_state.alarm_replay_guard_migrated = g_state.alarm_replay_guard_migrated ? 1 : 0;
    g_state.clock_24h_mode = g_state.clock_24h_mode ? 1 : 0;
    g_state.oled_color = clamp_int(g_state.oled_color, MP_OLED_COLOR_YELLOW, MP_OLED_COLOR_WHITE);
    for (int i = 0; i < MP_LED_SCENE_COUNT; i++)
        sanitize_led_profile(&g_state.led_profiles[i]);
    sanitize_led_settings(&g_state.led_settings);

    for (int i = 0; i < MAX_ALARMS; i++) {
        struct alarm_slot *a = &g_state.alarms[i];
        a->enabled = a->enabled ? 1 : 0;
        a->hour = clamp_int(a->hour, 0, 23);
        a->min = clamp_int(a->min, 0, 59);
        a->weekdays &= 0x7F;
        if (a->weekdays == 0) a->weekdays = 0x7F;
        a->start_volume = clamp_int(a->start_volume, 0, 100);
        a->end_volume = clamp_int(a->end_volume, 0, 100);
        if (a->last_fired_date < 19700101 || a->last_fired_date > 99991231)
            a->last_fired_date = 0;
        if (a->music_file[0] && (!safe_asset_filename(a->music_file) || !has_mp3_ext(a->music_file))) {
            a->music_file[0] = '\0';
        }
    }

    time_t now = time(NULL);
    if (g_state.pending_message_at > now + (time_t)(30 * 24 * 60 * 60)) {
        g_state.pending_message_at = 0;
        g_state.pending_message_image_file[0] = '\0';
        g_state.pending_message_image_bedtime = 0;
        g_state.pending_message_notification_sound = 0;
        g_state.pending_message_text[0] = '\0';
    } else if (g_state.pending_message_at > 0) {
        g_state.pending_message_image_bedtime = g_state.pending_message_image_bedtime ? 1 : 0;
        g_state.pending_message_notification_sound = g_state.pending_message_notification_sound ? 1 : 0;
        int pending_image_ok = 0;
        if (safe_image_filename(g_state.pending_message_image_file)) {
            char pending_path[512];
            pending_image_ok = make_image_path_by_file(
                g_state.pending_message_image_file,
                g_state.pending_message_image_bedtime,
                pending_path, sizeof(pending_path)) == 0 &&
                access(pending_path, R_OK) == 0;
        }
        if (!pending_image_ok)
            g_state.pending_message_image_file[0] = '\0';
        sanitize_message_text(g_state.pending_message_text, sizeof(g_state.pending_message_text));
        if (!g_state.pending_message_text[0] && !pending_image_ok) {
            g_state.pending_message_at = 0;
            g_state.pending_message_image_bedtime = 0;
            g_state.pending_message_notification_sound = 0;
        }
    } else {
        g_state.pending_message_image_file[0] = '\0';
        g_state.pending_message_image_bedtime = 0;
        g_state.pending_message_notification_sound = 0;
        g_state.pending_message_text[0] = '\0';
    }

    sanitize_clock_name(g_state.clock_name);
    if (g_state.oled_font < 0 || g_state.oled_font > SYSTEM_DEFAULT_FONT_ID)
        g_state.oled_font = SYSTEM_DEFAULT_FONT_ID;
    if (g_state.oled_font_size < 18 || g_state.oled_font_size > 54) g_state.oled_font_size = 48;
}

static int migrate_alarm_last_fired_dates(void) {
    if (g_state.alarm_replay_guard_migrated) return 0;

    g_state.alarm_replay_guard_migrated = 1;
    if (g_state.last_successful_alarm <= 0) return 1;

    time_t last_alarm = (time_t)g_state.last_successful_alarm;
    struct tm alarm_tm;
    if (!localtime_r(&last_alarm, &alarm_tm)) return 1;

    int date_key = local_date_key(&alarm_tm);
    if (date_key == 0) return 1;

    pthread_mutex_lock(&g_state.lock);
    for (int i = 0; i < MAX_ALARMS; i++) {
        struct alarm_slot *a = &g_state.alarms[i];
        int weekday_ok = (a->weekdays & (1 << alarm_tm.tm_wday)) != 0;
        if (a->last_fired_date == 0 && weekday_ok &&
            a->hour == alarm_tm.tm_hour && a->min == alarm_tm.tm_min) {
            a->last_fired_date = date_key;
        }
    }
    pthread_mutex_unlock(&g_state.lock);
    return 1;
}

/* ---------------- OLED low level ---------------- */

static int gpio_set(unsigned int offset, int value) {
    if (!g_oled.gpio_req) return -1;
    return gpiod_line_request_set_value(
        g_oled.gpio_req,
        offset,
        value ? GPIOD_LINE_VALUE_ACTIVE : GPIOD_LINE_VALUE_INACTIVE
    );
}

static int spi_write_bytes(const uint8_t *data, size_t len) {
    if (g_oled.spi_fd < 0) return -1;
    size_t off = 0;
    while (off < len) {
        size_t n = len - off;
        if (n > SPI_CHUNK) n = SPI_CHUNK;

        struct spi_ioc_transfer tr;
        memset(&tr, 0, sizeof(tr));
        tr.tx_buf = (unsigned long)(uintptr_t)(data + off);
        tr.len = (uint32_t)n;
        tr.speed_hz = SPI_SPEED_HZ;
        tr.bits_per_word = 8;

        if (ioctl(g_oled.spi_fd, SPI_IOC_MESSAGE(1), &tr) < 1) return -1;
        off += n;
    }
    return 0;
}

static int oled_cmd(uint8_t cmd) {
    gpio_set(GPIO_DC, 0);
    return spi_write_bytes(&cmd, 1);
}

static int oled_data(const uint8_t *data, size_t len) {
    gpio_set(GPIO_DC, 1);
    return spi_write_bytes(data, len);
}

static int oled_cmd1(uint8_t cmd, uint8_t a) {
    if (oled_cmd(cmd) != 0) return -1;
    return oled_data(&a, 1);
}

static int oled_cmd2(uint8_t cmd, uint8_t a, uint8_t b) {
    uint8_t d[2] = {a, b};
    if (oled_cmd(cmd) != 0) return -1;
    return oled_data(d, 2);
}

static int oled_set_brightness_percent(int percent) {
    percent = clamp_int(percent, 0, 100);
    if (g_oled.spi_fd < 0) return -1;

    /* SSD1322 brightness is much more obvious when both current controls move.
       0xC1 = contrast current, 0xC7 = master current. */
    /* Truncate instead of rounding at the low end. At 10%, rounding made
       both the master current and a white pixel level 2, causing a large
       jump above 0%. Truncation gives level 1 and minimum master current. */
    int hardware_percent = percent <= 0 ? 1 : percent;
    int contrast = (127 * hardware_percent) / 100;
    int master = (15 * hardware_percent) / 100;
    contrast = clamp_int(contrast, 1, 127);
    master = clamp_int(master, 1, 15);

    if (oled_cmd1(0xC1, (uint8_t)contrast) != 0) return -1;
    if (oled_cmd1(0xC7, (uint8_t)master) != 0) return -1;

    pthread_mutex_lock(&g_state.lock);
    g_state.oled_contrast_current = contrast;
    g_state.oled_master_current = master;
    g_state.oled_brightness_current = percent;
    g_state.display_dirty = 1;
    pthread_mutex_unlock(&g_state.lock);
    g_oled.prev_valid = 0;

    fprintf(stderr, "OLED brightness set: %d%% contrast=%d master=%d software-scale=%d%%\n", percent, contrast, master, percent);
    return 0;
}

static int time_in_window_minutes(int now_min, int start_min, int end_min) {
    if (start_min == end_min) return 0;
    if (start_min < end_min) return now_min >= start_min && now_min < end_min;
    return now_min >= start_min || now_min < end_min;
}

static void apply_bedtime_brightness(void) {
    int bedtime_enabled, sh, sm, eh, em, dim_pct, current_pct;
    int preview_pct;
    time_t preview_until;
    time_t now = time(NULL);

    pthread_mutex_lock(&g_state.lock);
    bedtime_enabled = g_state.bedtime_enabled;
    sh = g_state.bedtime_start_hour;
    sm = g_state.bedtime_start_min;
    eh = g_state.bedtime_end_hour;
    em = g_state.bedtime_end_min;
    dim_pct = g_state.bedtime_dim_percent;
    current_pct = g_state.oled_brightness_current;
    preview_pct = g_state.brightness_preview_percent;
    preview_until = g_state.brightness_preview_until;
    if (preview_until > 0 && preview_until <= now) {
        g_state.brightness_preview_percent = -1;
        g_state.brightness_preview_until = 0;
        preview_pct = -1;
        preview_until = 0;
    }
    pthread_mutex_unlock(&g_state.lock);

    struct tm tmv;
    localtime_r(&now, &tmv);
    int now_min = tmv.tm_hour * 60 + tmv.tm_min;
    int start_min = sh * 60 + sm;
    int end_min = eh * 60 + em;
    int in_bedtime = bedtime_enabled && time_in_window_minutes(now_min, start_min, end_min);

    /* A live GUI preview temporarily overrides the schedule. Once it expires,
       bedtime_dim_percent applies during bedtime and daytime returns to 100%. */
    int target_pct = preview_until > now && preview_pct >= 0
        ? clamp_int(preview_pct, 0, 100)
        : (in_bedtime ? clamp_int(dim_pct, 0, 100) : 100);
    if (target_pct != current_pct) oled_set_brightness_percent(target_pct);
}

static int is_bedtime_now(void) {
    int bedtime_enabled, sh, sm, eh, em;
    pthread_mutex_lock(&g_state.lock);
    bedtime_enabled = g_state.bedtime_enabled;
    sh = g_state.bedtime_start_hour;
    sm = g_state.bedtime_start_min;
    eh = g_state.bedtime_end_hour;
    em = g_state.bedtime_end_min;
    pthread_mutex_unlock(&g_state.lock);

    time_t now = time(NULL);
    struct tm tmv;
    localtime_r(&now, &tmv);
    int now_min = tmv.tm_hour * 60 + tmv.tm_min;
    return bedtime_enabled && time_in_window_minutes(now_min, sh * 60 + sm, eh * 60 + em);
}

static void update_led_scene(void) {
    time_t now = time(NULL);
    enum mp_led_scene scene = MP_LED_SCENE_DAYTIME;
    struct mp_led_profile profile;
    struct mp_led_profile preview_profile;
    struct mp_led_profile daytime_profile;
    struct mp_led_profile bedtime_profile;
    struct mp_led_global_settings settings;
    int preview_scene = -1;
    int preview_active = 0;
    int preview_bypass_master = 0;
    int preview_raw_output = 0;
    int alarm_active;
    int display_mode;
    time_t message_until;
    int story_playing;
    int audio_playing;
    int bedtime_enabled;
    int bedtime_start_hour;
    int bedtime_start_min;
    int touch_ok;
    int touch_pressed;

    pthread_mutex_lock(&g_state.lock);
    if (g_state.led_preview_until > 0 && g_state.led_preview_until <= now) {
        g_state.led_preview_until = 0;
        g_state.led_preview_scene = -1;
        g_state.led_preview_bypass_master = 0;
        g_state.led_preview_raw_output = 0;
    }
    if (g_state.led_preview_until > now &&
        g_state.led_preview_scene >= 0 &&
        g_state.led_preview_scene < MP_LED_SCENE_COUNT) {
        preview_scene = g_state.led_preview_scene;
        preview_profile = g_state.led_preview_profile;
        preview_bypass_master = g_state.led_preview_bypass_master;
        preview_raw_output = g_state.led_preview_raw_output;
        preview_active = 1;
    }
    alarm_active = g_state.alarm_active;
    display_mode = g_state.display_mode;
    message_until = g_state.message_until;
    story_playing = g_state.story_playing;
    audio_playing = g_state.audio_playing;
    bedtime_enabled = g_state.bedtime_enabled;
    bedtime_start_hour = g_state.bedtime_start_hour;
    bedtime_start_min = g_state.bedtime_start_min;
    daytime_profile = g_state.led_profiles[MP_LED_SCENE_DAYTIME];
    bedtime_profile = g_state.led_profiles[MP_LED_SCENE_BEDTIME];
    settings = g_state.led_settings;
    g_state.led_bedtime_fade_active = 0;
    pthread_mutex_unlock(&g_state.lock);
    touch_get_state(&touch_ok, &touch_pressed);

    /* Touch feedback is immediate. Alarm still wins once the press is released. */
    if (touch_ok && touch_pressed && settings.touch_blink_enabled) {
        scene = MP_LED_SCENE_TOUCH;
        profile = (struct mp_led_profile)LED_PROFILE(
            MP_LED_EFFECT_FADE, settings.touch_blink_brightness, 2,
            settings.touch_blink_red, settings.touch_blink_green, settings.touch_blink_blue,
            0, 0, 0);
    } else if (alarm_active) {
        scene = MP_LED_SCENE_ALARM;
        pthread_mutex_lock(&g_state.lock);
        profile = g_state.led_profiles[scene];
        pthread_mutex_unlock(&g_state.lock);
    } else if (preview_active) {
        scene = (enum mp_led_scene)preview_scene;
        profile = preview_profile;
    } else {
        if (display_mode == 2 && message_until > now) scene = MP_LED_SCENE_MESSAGE;
        else if (story_playing) scene = MP_LED_SCENE_STORIES;
        else if (audio_playing) scene = MP_LED_SCENE_MUSIC;
        else if (is_bedtime_now()) scene = MP_LED_SCENE_BEDTIME;
        else scene = MP_LED_SCENE_DAYTIME;

        pthread_mutex_lock(&g_state.lock);
        profile = g_state.led_profiles[scene];
        pthread_mutex_unlock(&g_state.lock);

        if (scene == MP_LED_SCENE_DAYTIME && settings.idle_off) {
            profile.brightness = 0;
        } else if (scene == MP_LED_SCENE_DAYTIME && bedtime_enabled &&
                   settings.bedtime_fade_minutes > 0) {
            struct tm tmv;
            localtime_r(&now, &tmv);
            int current_minute = tmv.tm_hour * 60 + tmv.tm_min;
            int start_minute = bedtime_start_hour * 60 + bedtime_start_min;
            int until_start = (start_minute - current_minute + 1440) % 1440;
            int fade_minutes = settings.bedtime_fade_minutes;
            if (until_start > 0 && until_start <= fade_minutes) {
                int elapsed = fade_minutes - until_start;
                int blended = ((int)daytime_profile.brightness * (fade_minutes - elapsed) +
                               (int)bedtime_profile.brightness * elapsed + fade_minutes / 2) /
                              fade_minutes;
                profile.brightness = (uint8_t)clamp_int(blended, 0, 100);
                pthread_mutex_lock(&g_state.lock);
                g_state.led_bedtime_fade_active = 1;
                pthread_mutex_unlock(&g_state.lock);
            }
        }
    }

    sanitize_led_profile(&profile);
    sanitize_led_settings(&settings);
    if (preview_active && preview_bypass_master) settings.enabled = 1;
    if (preview_active && preview_raw_output) {
        settings.enabled = 1;
        settings.max_brightness = 100;
        settings.red_gain = 100;
        settings.green_gain = 100;
        settings.blue_gain = 100;
    }
    mp_led_set_global(&settings);
    mp_led_set(scene, &profile);
}

static void oled_clear_fb(uint8_t gray4) {
    gray4 &= 0x0F;
    memset(oled_draw_fb(), (gray4 << 4) | gray4, OLED_FB_BYTES);
}

static void oled_set_px(int x, int y, uint8_t gray4) {
    if (x < 0 || y < 0 || x >= OLED_W || y >= OLED_H) return;
    uint8_t *fb = oled_draw_fb();
    gray4 &= 0x0F;
    size_t idx = (size_t)(y * OLED_W + x) / 2;
    if ((x & 1) == 0) {
        fb[idx] = (fb[idx] & 0x0F) | (gray4 << 4);
    } else {
        fb[idx] = (fb[idx] & 0xF0) | gray4;
    }
}

static uint8_t oled_get_px(int x, int y) {
    if (x < 0 || y < 0 || x >= OLED_W || y >= OLED_H) return 0;
    const uint8_t *fb = oled_draw_fb();
    size_t idx = (size_t)(y * OLED_W + x) / 2;
    if ((x & 1) == 0) return (fb[idx] >> 4) & 0x0F;
    return fb[idx] & 0x0F;
}

struct oled_visible_bounds {
    int left;
    int top;
    int right;
    int bottom;
};

static int oled_find_visible_bounds(int x0, int y0, int x1, int y1,
                                    struct oled_visible_bounds *bounds) {
    if (!bounds) return -1;
    x0 = clamp_int(x0, 0, OLED_W - 1);
    x1 = clamp_int(x1, 0, OLED_W - 1);
    y0 = clamp_int(y0, 0, OLED_H - 1);
    y1 = clamp_int(y1, 0, OLED_H - 1);
    if (x1 < x0 || y1 < y0) return -1;

    int left = OLED_W;
    int top = OLED_H;
    int right = -1;
    int bottom = -1;
    for (int y = y0; y <= y1; y++) {
        for (int x = x0; x <= x1; x++) {
            if (oled_get_px(x, y) == 0) continue;
            if (x < left) left = x;
            if (x > right) right = x;
            if (y < top) top = y;
            if (y > bottom) bottom = y;
        }
    }

    if (right < left || bottom < top) return -1;
    bounds->left = left;
    bounds->top = top;
    bounds->right = right;
    bounds->bottom = bottom;
    return 0;
}

static void draw_seconds_position_line(int second) {
    int sec = clamp_int(second, 0, 59);
    int gap_x = (sec * (OLED_W - 1)) / 59;
    for (int x = 0; x < OLED_W; x++)
        oled_set_px(x, CLOCK_SECONDS_LINE_Y,
                    x == gap_x ? 0 : CLOCK_SECONDS_LINE_LEVEL);
}

/*
 * FreeType gives us linear 0..255 coverage, but the SSD1322 OLED and human
 * perception make mid-gray anti-aliased pixels look too bright/fat.
 *
 * Quantize coverage to 4-bit, then apply a gamma-style LUT before blending.
 * This keeps full pixels fully bright while pulling edge pixels down so uploaded
 * TrueType/OpenType fonts look sharper on the 16-level grayscale OLED.
 *
 * Index:  linear 4-bit coverage from FreeType, 0..15
 * Value:  OLED-corrected 4-bit coverage, approx gamma 2.2
 */
static const uint8_t oled_coverage_gamma_lut[16] = {
    0, 0, 0, 1, 1, 2, 2, 3,
    4, 5, 6, 8, 9, 11, 13, 15
};

static uint8_t oled_coverage_to_gray4(uint8_t coverage, uint8_t gray4);

static void oled_blend_px(int x, int y, uint8_t coverage, uint8_t gray4) {
    uint8_t v = oled_coverage_to_gray4(coverage, gray4);
    if (v > oled_get_px(x, y)) oled_set_px(x, y, v);
}

static uint8_t ft_bitmap_coverage_at(const FT_Bitmap *bm, unsigned int row, unsigned int col) {
    if (!bm || !bm->buffer || row >= bm->rows || col >= bm->width) return 0;

    int pitch = bm->pitch;
    const uint8_t *row_data;
    if (pitch >= 0)
        row_data = bm->buffer + (size_t)row * (size_t)pitch;
    else
        row_data = bm->buffer + (size_t)(bm->rows - 1u - row) * (size_t)(-pitch);

    if (bm->pixel_mode == FT_PIXEL_MODE_GRAY) return row_data[col];
    if (bm->pixel_mode == FT_PIXEL_MODE_MONO)
        return (row_data[col >> 3] & (0x80u >> (col & 7u))) ? 255 : 0;
    return 0;
}

/* Find the final bitmap column that survives OLED coverage quantization. */
static int ft_bitmap_rightmost_visible_col(const FT_Bitmap *bm) {
    if (!bm || !bm->buffer || bm->width == 0 || bm->rows == 0) return -1;

    for (int col = (int)bm->width - 1; col >= 0; col--) {
        for (unsigned int row = 0; row < bm->rows; row++) {
            uint8_t coverage = ft_bitmap_coverage_at(bm, row, (unsigned int)col);
            uint8_t cov4 = (uint8_t)(((int)coverage * 15 + 127) / 255);
            if (oled_coverage_gamma_lut[cov4] != 0) return col;
        }
    }
    return -1;
}

/* Find the first bitmap column that survives OLED coverage quantization. */
static int ft_bitmap_leftmost_visible_col(const FT_Bitmap *bm) {
    if (!bm || !bm->buffer || bm->width == 0 || bm->rows == 0) return -1;

    for (unsigned int col = 0; col < bm->width; col++) {
        for (unsigned int row = 0; row < bm->rows; row++) {
            uint8_t coverage = ft_bitmap_coverage_at(bm, row, col);
            uint8_t cov4 = (uint8_t)(((int)coverage * 15 + 127) / 255);
            if (oled_coverage_gamma_lut[cov4] != 0) return (int)col;
        }
    }
    return -1;
}

static uint8_t oled_coverage_to_gray4(uint8_t coverage, uint8_t gray4) {
    if (coverage == 0 || (gray4 & 0x0F) == 0) return 0;

    uint8_t cov4 = (uint8_t)(((int)coverage * 15 + 127) / 255);
    uint8_t corrected = oled_coverage_gamma_lut[cov4];
    if (corrected == 0) return 0;

    return (uint8_t)(((int)corrected * (int)(gray4 & 0x0F) + 7) / 15);
}

static void oled_fill_rect(int x, int y, int w, int h, uint8_t gray4) {
    for (int yy = y; yy < y + h; yy++) {
        for (int xx = x; xx < x + w; xx++) {
            oled_set_px(xx, yy, gray4);
        }
    }
}



static void oled_apply_brightness_to_buffer(uint8_t *buffer, size_t len, int brightness_percent) {
    if (!buffer || len == 0) return;
    brightness_percent = clamp_int(brightness_percent < 0 ? 100 : brightness_percent, 0, 100);
    if (brightness_percent >= 100) return;

    for (size_t i = 0; i < len; i++) {
        uint8_t hi = (buffer[i] >> 4) & 0x0F;
        uint8_t lo = buffer[i] & 0x0F;
        uint8_t original_hi = hi;
        uint8_t original_lo = lo;
        hi = (uint8_t)((hi * brightness_percent) / 100);
        lo = (uint8_t)((lo * brightness_percent) / 100);
        /* Any non-zero slider value remains visible at the panel's minimum
           grayscale step instead of behaving like 0%. */
        if (brightness_percent > 0 && original_hi > 0 && hi == 0) hi = 1;
        if (brightness_percent > 0 && original_lo > 0 && lo == 0) lo = 1;
        if (hi > 15) hi = 15;
        if (lo > 15) lo = 15;
        buffer[i] = (uint8_t)((hi << 4) | lo);
    }
}

static int oled_flush_region_bytes(int byte_start, int byte_end, int row_start, int row_end) {
    static uint8_t tmp[OLED_FB_BYTES];

    if (g_oled.spi_fd < 0) return -1;

    if (byte_start < 0) byte_start = 0;
    if (byte_end >= OLED_ROW_BYTES) byte_end = OLED_ROW_BYTES - 1;
    if (row_start < 0) row_start = 0;
    if (row_end >= OLED_H) row_end = OLED_H - 1;
    if (byte_end < byte_start || row_end < row_start) return 0;

    /* SSD1322 column addressing is effectively 4 pixels wide on these modules,
       so align dirty byte ranges to 2-byte boundaries. */
    byte_start &= ~1;
    byte_end |= 1;
    if (byte_end >= OLED_ROW_BYTES) byte_end = OLED_ROW_BYTES - 1;

    int width_bytes = byte_end - byte_start + 1;
    int height = row_end - row_start + 1;
    size_t tmp_len = (size_t)width_bytes * (size_t)height;
    if (tmp_len > sizeof(tmp)) return -1;

    for (int y = 0; y < height; y++) {
        memcpy(tmp + ((size_t)y * (size_t)width_bytes),
               g_oled.fb + ((size_t)(row_start + y) * OLED_ROW_BYTES) + byte_start,
               (size_t)width_bytes);
    }

    int brightness_percent = 100;
    pthread_mutex_lock(&g_state.lock);
    brightness_percent = g_state.oled_brightness_current;
    pthread_mutex_unlock(&g_state.lock);
    oled_apply_brightness_to_buffer(tmp, tmp_len, brightness_percent);

    int col_start = 0x1C + (byte_start / 2);
    int col_end = 0x1C + (byte_end / 2);
    int rc = 0;

    if (oled_cmd2(0x15, (uint8_t)col_start, (uint8_t)col_end) != 0) rc = -1;
    else if (oled_cmd2(0x75, (uint8_t)row_start, (uint8_t)row_end) != 0) rc = -1;
    else if (oled_cmd(0x5C) != 0) rc = -1;
    else if (oled_data(tmp, tmp_len) != 0) rc = -1;

    if (rc == 0) {
        pthread_mutex_lock(&g_oled.preview_lock);
        for (int y = 0; y < height; y++) {
            memcpy(g_oled.preview_fb + ((size_t)(row_start + y) * OLED_ROW_BYTES) + byte_start,
                   tmp + ((size_t)y * (size_t)width_bytes),
                   (size_t)width_bytes);
        }
        pthread_mutex_unlock(&g_oled.preview_lock);

        /* Track the raw framebuffer bytes that are now represented on the
           panel. This also keeps direct partial updates, such as the music
           marquee footer, synchronized with the dirty-region comparator. */
        if (g_oled.prev_valid) {
            for (int y = 0; y < height; y++) {
                memcpy(g_oled.prev_fb + ((size_t)(row_start + y) * OLED_ROW_BYTES) + byte_start,
                       g_oled.fb + ((size_t)(row_start + y) * OLED_ROW_BYTES) + byte_start,
                       (size_t)width_bytes);
            }
        }
    }

    return rc;
}

static int oled_flush_full(void) {
    int rc = oled_flush_region_bytes(0, OLED_ROW_BYTES - 1, 0, OLED_H - 1);
    if (rc == 0) {
        memcpy(g_oled.prev_fb, g_oled.fb, sizeof(g_oled.fb));
        g_oled.prev_valid = 1;
    }
    return rc;
}

static int oled_flush(void) {
    if (g_oled.spi_fd < 0) return -1;
    if (!g_oled.prev_valid) return oled_flush_full();

    int row_min[OLED_H];
    int row_max[OLED_H];

    for (int y = 0; y < OLED_H; y++) {
        row_min[y] = OLED_ROW_BYTES;
        row_max[y] = -1;

        const uint8_t *cur = g_oled.fb + ((size_t)y * OLED_ROW_BYTES);
        const uint8_t *old = g_oled.prev_fb + ((size_t)y * OLED_ROW_BYTES);
        for (int bx = 0; bx < OLED_ROW_BYTES; bx++) {
            if (cur[bx] == old[bx]) continue;
            if (bx < row_min[y]) row_min[y] = bx;
            if (bx > row_max[y]) row_max[y] = bx;
        }
    }

    /* Flush each contiguous dirty row band independently. A single bounding
       rectangle made the blinking colon and seconds line span nearly the full
       panel, rewriting unchanged image RAM every second. Separate bands keep
       static artwork untouched while still allowing full redraws when needed. */
    int y = 0;
    while (y < OLED_H) {
        while (y < OLED_H && row_max[y] < row_min[y]) y++;
        if (y >= OLED_H) break;

        int band_start = y;
        int band_end = y;
        int band_min = row_min[y];
        int band_max = row_max[y];

        while (band_end + 1 < OLED_H &&
               row_max[band_end + 1] >= row_min[band_end + 1]) {
            int next_min = row_min[band_end + 1];
            int next_max = row_max[band_end + 1];

            /* Merge vertically only when the byte ranges overlap or touch.
               This prevents an unrelated seconds-line change from widening a
               colon update into a rectangle that crosses static artwork. */
            if (next_min > band_max + 1 || next_max + 1 < band_min) break;

            band_end++;
            if (next_min < band_min) band_min = next_min;
            if (next_max > band_max) band_max = next_max;
        }

        if (oled_flush_region_bytes(band_min, band_max,
                                    band_start, band_end) != 0)
            return -1;

        y = band_end + 1;
    }

    memcpy(g_oled.prev_fb, g_oled.fb, sizeof(g_oled.fb));
    return 0;
}

static int oled_init(void) {
    g_oled.spi_fd = open(OLED_SPI_DEV, O_RDWR);
    if (g_oled.spi_fd < 0) {
        perror("open spi");
        return -1;
    }

    uint8_t mode = SPI_MODE_0;
    uint8_t bits = 8;
    uint32_t speed = SPI_SPEED_HZ;

    if (ioctl(g_oled.spi_fd, SPI_IOC_WR_MODE, &mode) < 0) perror("SPI_IOC_WR_MODE");
    if (ioctl(g_oled.spi_fd, SPI_IOC_WR_BITS_PER_WORD, &bits) < 0) perror("SPI bits");
    if (ioctl(g_oled.spi_fd, SPI_IOC_WR_MAX_SPEED_HZ, &speed) < 0) perror("SPI speed");

    g_oled.chip = gpiod_chip_open(GPIO_CHIP);
    if (!g_oled.chip) {
        perror("gpiod_chip_open");
        return -1;
    }

    unsigned int offsets[2] = { GPIO_DC, GPIO_RST };

    struct gpiod_line_settings *settings = gpiod_line_settings_new();
    struct gpiod_line_config *line_cfg = gpiod_line_config_new();
    struct gpiod_request_config *req_cfg = gpiod_request_config_new();

    if (!settings || !line_cfg || !req_cfg) {
        fprintf(stderr, "failed to allocate gpio request config\n");
        if (settings) gpiod_line_settings_free(settings);
        if (line_cfg) gpiod_line_config_free(line_cfg);
        if (req_cfg) gpiod_request_config_free(req_cfg);
        return -1;
    }

    gpiod_line_settings_set_direction(settings, GPIOD_LINE_DIRECTION_OUTPUT);
    gpiod_line_settings_set_output_value(settings, GPIOD_LINE_VALUE_INACTIVE);

    if (gpiod_line_config_add_line_settings(line_cfg, offsets, 2, settings) != 0) {
        perror("gpiod_line_config_add_line_settings");
        gpiod_line_settings_free(settings);
        gpiod_line_config_free(line_cfg);
        gpiod_request_config_free(req_cfg);
        return -1;
    }

    gpiod_request_config_set_consumer(req_cfg, APP_NAME);

    g_oled.gpio_req = gpiod_chip_request_lines(g_oled.chip, req_cfg, line_cfg);

    gpiod_line_settings_free(settings);
    gpiod_line_config_free(line_cfg);
    gpiod_request_config_free(req_cfg);

    if (!g_oled.gpio_req) {
        perror("gpiod_chip_request_lines");
        return -1;
    }

    gpio_set(GPIO_RST, 0);
    usleep(100000);
    gpio_set(GPIO_RST, 1);
    usleep(100000);

    oled_cmd1(0xFD, 0x12);       /* unlock */
    oled_cmd(0xAE);              /* display off */
    oled_cmd1(0xB3, 0x91);       /* clock */
    oled_cmd1(0xCA, 0x3F);       /* mux ratio 64 */
    oled_cmd1(0xA2, 0x00);       /* display offset */
    oled_cmd1(0xA1, 0x00);       /* start line */
    oled_cmd2(0xA0, 0x14, 0x11); /* remap */
    oled_cmd1(0xAB, 0x01);       /* function select */
    oled_cmd1(0xB4, 0xA0);       /* display enhancement A */
    oled_data((uint8_t[]){0xFD}, 1);
    oled_cmd1(0xC1, 0x7F);       /* contrast */
    oled_cmd1(0xC7, 0x0F);       /* master contrast */
    oled_cmd1(0xB1, 0xE2);       /* phase length */
    oled_cmd1(0xD1, 0x82);       /* display enhancement B */
    oled_cmd1(0xBB, 0x1F);       /* precharge voltage */
    oled_cmd1(0xB6, 0x08);       /* second precharge */
    oled_cmd1(0xBE, 0x07);       /* VCOMH */
    oled_cmd(0xA6);              /* normal display */
    oled_cmd(0xAF);              /* display on */

    oled_clear_fb(0);
    oled_flush();
    return 0;
}

static void oled_close(void) {
    if (g_oled.spi_fd >= 0) close(g_oled.spi_fd);
    g_oled.spi_fd = -1;
    if (g_oled.gpio_req) gpiod_line_request_release(g_oled.gpio_req);
    g_oled.gpio_req = NULL;
    if (g_oled.chip) gpiod_chip_close(g_oled.chip);
}

/* ---------------- Clock drawing ---------------- */

static void draw_seg_digit(int x, int y, int w, int h, int t, int digit, uint8_t c) {
    static const uint8_t segs[10] = {
        0x3F, /* 0 abcdef */
        0x06, /* 1 bc */
        0x5B, /* 2 abged */
        0x4F, /* 3 abgcd */
        0x66, /* 4 fgbc */
        0x6D, /* 5 afgcd */
        0x7D, /* 6 afgcde */
        0x07, /* 7 abc */
        0x7F, /* 8 */
        0x6F  /* 9 */
    };
    if (digit < 0 || digit > 9) return;
    if (t < 1) t = 1;
    uint8_t s = segs[digit];
    int mid = y + h / 2;

    if (s & 0x01) oled_fill_rect(x + t, y, w - 2 * t, t, c);              /* a */
    if (s & 0x02) oled_fill_rect(x + w - t, y + t, t, h / 2 - t, c);      /* b */
    if (s & 0x04) oled_fill_rect(x + w - t, mid, t, h / 2 - t, c);        /* c */
    if (s & 0x08) oled_fill_rect(x + t, y + h - t, w - 2 * t, t, c);      /* d */
    if (s & 0x10) oled_fill_rect(x, mid, t, h / 2 - t, c);                /* e */
    if (s & 0x20) oled_fill_rect(x, y + t, t, h / 2 - t, c);              /* f */
    if (s & 0x40) oled_fill_rect(x + t, mid - t / 2, w - 2 * t, t, c);    /* g */
}

static void draw_seg_colon(int x, int y, int dot, uint8_t c) {
    oled_fill_rect(x, y + 17, dot, dot, c);
    oled_fill_rect(x, y + 36, dot, dot, c);
}

static const uint8_t font5x7_digits[10][7] = {
    {0x0E,0x11,0x13,0x15,0x19,0x11,0x0E}, /* 0 */
    {0x04,0x0C,0x04,0x04,0x04,0x04,0x0E}, /* 1 */
    {0x0E,0x11,0x01,0x02,0x04,0x08,0x1F}, /* 2 */
    {0x1E,0x01,0x01,0x0E,0x01,0x01,0x1E}, /* 3 */
    {0x02,0x06,0x0A,0x12,0x1F,0x02,0x02}, /* 4 */
    {0x1F,0x10,0x10,0x1E,0x01,0x01,0x1E}, /* 5 */
    {0x0E,0x10,0x10,0x1E,0x11,0x11,0x0E}, /* 6 */
    {0x1F,0x01,0x02,0x04,0x08,0x08,0x08}, /* 7 */
    {0x0E,0x11,0x11,0x0E,0x11,0x11,0x0E}, /* 8 */
    {0x0E,0x11,0x11,0x0F,0x01,0x01,0x0E}  /* 9 */
};


static uint32_t utf8_next_codepoint(const unsigned char **cursor);

static const uint8_t font5x7_unknown[7] = {0x1F,0x11,0x01,0x02,0x04,0x00,0x04};
static const uint8_t font5x7_a_umlaut[7] = {0x0A,0x00,0x0E,0x11,0x1F,0x11,0x11};
static const uint8_t font5x7_e_umlaut[7] = {0x0A,0x00,0x1F,0x10,0x1E,0x10,0x1F};
static const uint8_t font5x7_i_umlaut[7] = {0x0A,0x00,0x0E,0x04,0x04,0x04,0x0E};
static const uint8_t font5x7_o_umlaut[7] = {0x0A,0x00,0x0E,0x11,0x11,0x11,0x0E};
static const uint8_t font5x7_u_umlaut[7] = {0x0A,0x00,0x11,0x11,0x11,0x11,0x0E};
static const uint8_t font5x7_y_umlaut[7] = {0x0A,0x00,0x11,0x0A,0x04,0x04,0x04};

static const uint8_t font5x7_table[128][7] = {
    [' '] = {0x00,0x00,0x00,0x00,0x00,0x00,0x00},
    ['-'] = {0x00,0x00,0x00,0x1F,0x00,0x00,0x00},
    ['.'] = {0x00,0x00,0x00,0x00,0x00,0x0C,0x0C},
    [','] = {0x00,0x00,0x00,0x00,0x00,0x04,0x08},
    ['%'] = {0x18,0x19,0x02,0x04,0x08,0x13,0x03},
    [':'] = {0x00,0x0C,0x0C,0x00,0x0C,0x0C,0x00},
    ['\''] = {0x04,0x04,0x08,0x00,0x00,0x00,0x00},
    ['!'] = {0x04,0x04,0x04,0x04,0x04,0x00,0x04},
    ['?'] = {0x0E,0x11,0x01,0x02,0x04,0x00,0x04},
    ['_'] = {0x00,0x00,0x00,0x00,0x00,0x00,0x1F},
    ['/'] = {0x01,0x02,0x02,0x04,0x08,0x08,0x10},
    ['0'] = {0x0E,0x11,0x13,0x15,0x19,0x11,0x0E},
    ['1'] = {0x04,0x0C,0x04,0x04,0x04,0x04,0x0E},
    ['2'] = {0x0E,0x11,0x01,0x02,0x04,0x08,0x1F},
    ['3'] = {0x1E,0x01,0x01,0x0E,0x01,0x01,0x1E},
    ['4'] = {0x02,0x06,0x0A,0x12,0x1F,0x02,0x02},
    ['5'] = {0x1F,0x10,0x10,0x1E,0x01,0x01,0x1E},
    ['6'] = {0x0E,0x10,0x10,0x1E,0x11,0x11,0x0E},
    ['7'] = {0x1F,0x01,0x02,0x04,0x08,0x08,0x08},
    ['8'] = {0x0E,0x11,0x11,0x0E,0x11,0x11,0x0E},
    ['9'] = {0x0E,0x11,0x11,0x0F,0x01,0x01,0x0E},
    ['A'] = {0x0E,0x11,0x11,0x1F,0x11,0x11,0x11},
    ['B'] = {0x1E,0x11,0x11,0x1E,0x11,0x11,0x1E},
    ['C'] = {0x0E,0x11,0x10,0x10,0x10,0x11,0x0E},
    ['D'] = {0x1E,0x11,0x11,0x11,0x11,0x11,0x1E},
    ['E'] = {0x1F,0x10,0x10,0x1E,0x10,0x10,0x1F},
    ['F'] = {0x1F,0x10,0x10,0x1E,0x10,0x10,0x10},
    ['G'] = {0x0E,0x11,0x10,0x17,0x11,0x11,0x0E},
    ['H'] = {0x11,0x11,0x11,0x1F,0x11,0x11,0x11},
    ['I'] = {0x0E,0x04,0x04,0x04,0x04,0x04,0x0E},
    ['J'] = {0x07,0x02,0x02,0x02,0x12,0x12,0x0C},
    ['K'] = {0x11,0x12,0x14,0x18,0x14,0x12,0x11},
    ['L'] = {0x10,0x10,0x10,0x10,0x10,0x10,0x1F},
    ['M'] = {0x11,0x1B,0x15,0x15,0x11,0x11,0x11},
    ['N'] = {0x11,0x19,0x15,0x13,0x11,0x11,0x11},
    ['O'] = {0x0E,0x11,0x11,0x11,0x11,0x11,0x0E},
    ['P'] = {0x1E,0x11,0x11,0x1E,0x10,0x10,0x10},
    ['Q'] = {0x0E,0x11,0x11,0x11,0x15,0x12,0x0D},
    ['R'] = {0x1E,0x11,0x11,0x1E,0x14,0x12,0x11},
    ['S'] = {0x0F,0x10,0x10,0x0E,0x01,0x01,0x1E},
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
};

static const uint8_t font5x7_known[128] = {
    [' '] = 1, ['-'] = 1, ['.'] = 1, [','] = 1, ['%'] = 1,
    [':'] = 1, ['\''] = 1, ['!'] = 1, ['?'] = 1, ['_'] = 1, ['/'] = 1,
    ['0'] = 1, ['1'] = 1, ['2'] = 1, ['3'] = 1, ['4'] = 1,
    ['5'] = 1, ['6'] = 1, ['7'] = 1, ['8'] = 1, ['9'] = 1,
    ['A'] = 1, ['B'] = 1, ['C'] = 1, ['D'] = 1, ['E'] = 1,
    ['F'] = 1, ['G'] = 1, ['H'] = 1, ['I'] = 1, ['J'] = 1,
    ['K'] = 1, ['L'] = 1, ['M'] = 1, ['N'] = 1, ['O'] = 1,
    ['P'] = 1, ['Q'] = 1, ['R'] = 1, ['S'] = 1, ['T'] = 1,
    ['U'] = 1, ['V'] = 1, ['W'] = 1, ['X'] = 1, ['Y'] = 1, ['Z'] = 1
};

static const uint8_t *font5x7_glyph(uint32_t cp) {
    switch (cp) {
        case 0x00c4: case 0x00e4: return font5x7_a_umlaut;
        case 0x00cb: case 0x00eb: return font5x7_e_umlaut;
        case 0x00cf: case 0x00ef: return font5x7_i_umlaut;
        case 0x00d6: case 0x00f6: return font5x7_o_umlaut;
        case 0x00dc: case 0x00fc: return font5x7_u_umlaut;
        case 0x0178: case 0x00ff: return font5x7_y_umlaut;
        default: break;
    }

    unsigned char idx = 0;
    if (cp < 0x80) {
        idx = (unsigned char)cp;
    } else {
        switch (cp) {
            case 0x00c0: case 0x00c1: case 0x00c2: case 0x00c3: case 0x00c5:
            case 0x00e0: case 0x00e1: case 0x00e2: case 0x00e3: case 0x00e5:
            case 0x0100: case 0x0101: case 0x0102: case 0x0103: case 0x0104: case 0x0105:
            case 0x00c6: case 0x00e6:
                idx = 'A'; break;
            case 0x00c7: case 0x00e7: case 0x0106: case 0x0107: case 0x010c: case 0x010d:
                idx = 'C'; break;
            case 0x00d0: case 0x00f0: case 0x010e: case 0x010f:
                idx = 'D'; break;
            case 0x00c8: case 0x00c9: case 0x00ca:
            case 0x00e8: case 0x00e9: case 0x00ea:
            case 0x0112: case 0x0113: case 0x0116: case 0x0117: case 0x0118: case 0x0119:
                idx = 'E'; break;
            case 0x011e: case 0x011f:
                idx = 'G'; break;
            case 0x00cc: case 0x00cd: case 0x00ce:
            case 0x00ec: case 0x00ed: case 0x00ee:
            case 0x012a: case 0x012b: case 0x012e: case 0x012f:
                idx = 'I'; break;
            case 0x0139: case 0x013a: case 0x013d: case 0x013e: case 0x0141: case 0x0142:
                idx = 'L'; break;
            case 0x00d1: case 0x00f1: case 0x0143: case 0x0144: case 0x0147: case 0x0148:
                idx = 'N'; break;
            case 0x00d2: case 0x00d3: case 0x00d4: case 0x00d5: case 0x00d8:
            case 0x00f2: case 0x00f3: case 0x00f4: case 0x00f5: case 0x00f8:
            case 0x014c: case 0x014d: case 0x0150: case 0x0151: case 0x0152: case 0x0153:
                idx = 'O'; break;
            case 0x0154: case 0x0155: case 0x0158: case 0x0159:
                idx = 'R'; break;
            case 0x015a: case 0x015b: case 0x0160: case 0x0161: case 0x00df:
                idx = 'S'; break;
            case 0x0164: case 0x0165: case 0x00de: case 0x00fe:
                idx = 'T'; break;
            case 0x00d9: case 0x00da: case 0x00db:
            case 0x00f9: case 0x00fa: case 0x00fb:
            case 0x016a: case 0x016b: case 0x016e: case 0x016f: case 0x0170: case 0x0171:
                idx = 'U'; break;
            case 0x00dd: case 0x00fd:
                idx = 'Y'; break;
            case 0x0179: case 0x017a: case 0x017b: case 0x017c: case 0x017d: case 0x017e:
                idx = 'Z'; break;
            case 0x00a0:
                idx = ' '; break;
            case 0x2010: case 0x2011: case 0x2012: case 0x2013: case 0x2014: case 0x2212:
                idx = '-'; break;
            case 0x2018: case 0x2019: case 0x201a: case 0x201b:
            case 0x201c: case 0x201d: case 0x201e: case 0x201f:
                idx = '\''; break;
            default:
                return font5x7_unknown;
        }
    }

    if (idx >= 'a' && idx <= 'z') idx = (unsigned char)(idx - 'a' + 'A');
    if (idx < 128 && font5x7_known[idx]) return font5x7_table[idx];
    return font5x7_unknown;
}

static int text5x7_width(const char *text, int scale) {
    if (!text || !*text) return 0;
    if (scale < 1) scale = 1;
    int n = 0;
    const unsigned char *cursor = (const unsigned char *)text;
    while (*cursor) {
        uint32_t cp = utf8_next_codepoint(&cursor);
        if (cp >= 0x0300 && cp <= 0x036f) continue;
        n++;
    }
    return n > 0 ? n * 5 * scale + (n - 1) * scale : 0;
}

/* Return the visible 5x7 ink span, excluding blank trailing glyph columns. */
static int text5x7_ink_width(const char *text) {
    if (!text || !*text) return 0;

    int pen_x = 0;
    int rightmost = -1;
    const unsigned char *cursor = (const unsigned char *)text;
    while (*cursor) {
        uint32_t cp = utf8_next_codepoint(&cursor);
        if (cp >= 0x0300 && cp <= 0x036f) continue;

        const uint8_t *glyph = font5x7_glyph(cp);
        for (int row = 0; row < 7; row++) {
            uint8_t bits = glyph[row];
            for (int col = 0; col < 5; col++) {
                if ((bits & (1 << (4 - col))) && pen_x + col > rightmost)
                    rightmost = pen_x + col;
            }
        }
        pen_x += 6;
    }

    return rightmost >= 0 ? rightmost + 1 : 0;
}

static void draw_char5x7(int x, int y, int scale, uint32_t cp, uint8_t c) {
    const uint8_t *g = font5x7_glyph(cp);
    if (scale < 1) scale = 1;
    for (int row = 0; row < 7; row++) {
        uint8_t bits = g[row];
        for (int col = 0; col < 5; col++) {
            if (bits & (1 << (4 - col))) {
                oled_fill_rect(x + col * scale, y + row * scale, scale, scale, c);
            }
        }
    }
}

static void draw_text5x7(int x, int y, int scale, const char *text, uint8_t c) {
    if (!text) return;
    if (scale < 1) scale = 1;
    const unsigned char *cursor = (const unsigned char *)text;
    while (*cursor) {
        uint32_t cp = utf8_next_codepoint(&cursor);
        if (cp >= 0x0300 && cp <= 0x036f) continue;
        draw_char5x7(x, y, scale, cp, c);
        x += 6 * scale;
    }
}


static uint64_t monotonic_millis(void) {
    struct timespec ts;
    if (clock_gettime(CLOCK_MONOTONIC, &ts) != 0) return 0;
    return (uint64_t)ts.tv_sec * 1000u + (uint64_t)ts.tv_nsec / 1000000u;
}

static uint32_t utf8_next_codepoint(const unsigned char **cursor) {
    const unsigned char *p = cursor ? *cursor : NULL;
    if (!p || !*p) return 0;

    uint32_t cp;
    size_t count;
    if (p[0] < 0x80) {
        cp = p[0];
        count = 1;
    } else if ((p[0] & 0xe0) == 0xc0 && p[1]) {
        cp = (uint32_t)(p[0] & 0x1f);
        count = 2;
    } else if ((p[0] & 0xf0) == 0xe0 && p[1] && p[2]) {
        cp = (uint32_t)(p[0] & 0x0f);
        count = 3;
    } else if ((p[0] & 0xf8) == 0xf0 && p[1] && p[2] && p[3]) {
        cp = (uint32_t)(p[0] & 0x07);
        count = 4;
    } else {
        *cursor = p + 1;
        return 0xfffd;
    }

    for (size_t i = 1; i < count; i++) {
        if ((p[i] & 0xc0) != 0x80) {
            *cursor = p + 1;
            return 0xfffd;
        }
        cp = (cp << 6) | (uint32_t)(p[i] & 0x3f);
    }

    if ((count == 2 && cp < 0x80) ||
        (count == 3 && cp < 0x800) ||
        (count == 4 && cp < 0x10000) ||
        cp > 0x10ffff || (cp >= 0xd800 && cp <= 0xdfff)) {
        *cursor = p + 1;
        return 0xfffd;
    }

    *cursor = p + count;
    return cp;
}

static void draw_char5x7_clipped(int x, int y, uint32_t cp, uint8_t c, int clip_x0, int clip_x1) {
    const uint8_t *glyph = font5x7_glyph(cp);
    for (int row = 0; row < 7; row++) {
        uint8_t bits = glyph[row];
        for (int col = 0; col < 5; col++) {
            int px = x + col;
            if (px < clip_x0 || px >= clip_x1) continue;
            if (bits & (1 << (4 - col))) oled_set_px(px, y + row, c);
        }
    }
}

static void draw_text5x7_clipped(int x, int y, const char *text, uint8_t c, int clip_x0, int clip_x1) {
    if (!text || clip_x1 <= clip_x0) return;
    const unsigned char *cursor = (const unsigned char *)text;
    while (*cursor) {
        uint32_t cp = utf8_next_codepoint(&cursor);
        if (cp >= 0x0300 && cp <= 0x036f) continue;
        if (x >= clip_x1) break;
        if (x + 5 > clip_x0) draw_char5x7_clipped(x, y, cp, c, clip_x0, clip_x1);
        x += 6;
    }
}

static int song_marquee_offset(int cycle_width, uint64_t started_ms) {
    if (cycle_width <= 0) return 0;
    uint64_t now_ms = monotonic_millis();
    uint64_t elapsed = now_ms >= started_ms ? now_ms - started_ms : 0;
    uint64_t pixels = (elapsed * SONG_SCROLL_SPEED_PX_PER_SEC) / 1000u;
    return (int)(pixels % (uint64_t)cycle_width);
}

static void draw_song_metadata_line(const char *text, uint64_t started_ms,
                                    int min_x, int right_pixel) {
    if (!text || !*text) return;

    int clip_x0 = clamp_int(min_x, 0, OLED_W - 3);
    int clip_x1 = clamp_int(right_pixel + 1, clip_x0 + 1, OLED_W);
    int available = right_pixel - clip_x0 + 1;
    if (available <= 0) return;

    int width = text5x7_ink_width(text);
    if (width <= 0) return;
    if (width <= available) {
        draw_text5x7_clipped(right_pixel - width + 1, CLOCK_FOOTER_TEXT_Y, text, 11,
                             clip_x0, clip_x1);
        return;
    }

    int cycle_width = width + SONG_SCROLL_GAP_PX;
    int x = right_pixel - width + 1 - song_marquee_offset(cycle_width, started_ms);
    draw_text5x7_clipped(x, CLOCK_FOOTER_TEXT_Y, text, 11,
                         clip_x0, clip_x1);
    x += cycle_width;
    draw_text5x7_clipped(x, CLOCK_FOOTER_TEXT_Y, text, 11,
                         clip_x0, clip_x1);
}

static void draw_version_corner(void) {
    char ver[48];
    snprintf(ver, sizeof(ver), "v%s", APP_VERSION);
    int w = text5x7_width(ver, 1);
    draw_text5x7(OLED_W - w - 2, OLED_H - 8, 1, ver, 8);
}


static void format_footer_alarm_label(const struct alarm_slot alarms[MAX_ALARMS],
                                      time_t now, int clock_24h_mode,
                                      char *out, size_t out_len) {
    if (!out || out_len == 0) return;
    out[0] = '\0';

    time_t next = next_alarm_time(alarms, now, NULL);
    if (next <= 0) return;

    struct tm tmv;
    localtime_r(&next, &tmv);
    char clock[24];
    strftime(clock, sizeof(clock), clock_24h_mode ? "%H:%M" : "%I:%M%p", &tmv);
    if (!clock_24h_mode && clock[0] == '0') memmove(clock, clock + 1, strlen(clock));
    snprintf(out, out_len, "ALARM %s", clock);
}

static int draw_status_labels(const char *alarm_label, int alarm_active) {
    const int y = CLOCK_FOOTER_TEXT_Y;
    if (!alarm_label || !*alarm_label) return CLOCK_STATUS_TEXT_X;

    const char *label = alarm_label;
    int width = text5x7_width(label, 1);
    draw_text5x7(CLOCK_STATUS_TEXT_X, y, 1, label, alarm_active ? 15 : 11);
    return CLOCK_STATUS_TEXT_X + width + CLOCK_STATUS_CONTENT_GAP;
}

static void draw_startup_screen(void) {
    char name[64];
    pthread_mutex_lock(&g_state.lock);
    safe_str(name, sizeof(name), g_state.clock_name);
    pthread_mutex_unlock(&g_state.lock);
    sanitize_clock_name(name);

    char msg[96];
    snprintf(msg, sizeof(msg), "Hi %s", name);

    int scale = 3;
    while (scale > 1 && text5x7_width(msg, scale) > OLED_W - 14) scale--;

    int max_chars = (OLED_W - 14 + scale) / (6 * scale);
    if (max_chars < 4) max_chars = 4;
    if ((int)strlen(msg) > max_chars) {
        if (max_chars > 3) {
            msg[max_chars - 3] = '.';
            msg[max_chars - 2] = '.';
            msg[max_chars - 1] = '.';
            msg[max_chars] = '\0';
        } else {
            msg[max_chars] = '\0';
        }
    }

    oled_clear_fb(0);
    int w = text5x7_width(msg, scale);
    int x = (OLED_W - w) / 2;
    if (x < 0) x = 0;
    int y = (OLED_H - (7 * scale)) / 2 - 4;
    if (y < 0) y = 0;
    draw_text5x7(x, y, scale, msg, 15);
    draw_version_corner();
    oled_flush_full();
}

static void draw_pixel_digit(int x, int y, int sx, int sy, int digit, uint8_t c, int bold) {
    if (digit < 0 || digit > 9) return;
    for (int row = 0; row < 7; row++) {
        uint8_t bits = font5x7_digits[digit][row];
        for (int col = 0; col < 5; col++) {
            if (bits & (1 << (4 - col))) {
                int bw = sx + (bold ? 1 : 0);
                oled_fill_rect(x + col * sx, y + row * sy, bw, sy, c);
            }
        }
    }
}

static void draw_pixel_colon(int x, int y, int sx, int sy, uint8_t c, int bold) {
    int dot_w = sx + (bold ? 1 : 0);
    oled_fill_rect(x, y + sy * 2, dot_w, sy, c);
    oled_fill_rect(x, y + sy * 4, dot_w, sy, c);
}

static void font_cache_close_locked(void) {
    if (g_font.face) {
        FT_Done_Face(g_font.face);
        g_font.face = NULL;
    }
    if (g_font.library) {
        FT_Done_FreeType(g_font.library);
        g_font.library = NULL;
    }
    g_font.loaded_file[0] = '\0';
    g_font.loaded_size = 0;
}

static void font_cache_reset(void) {
    pthread_mutex_lock(&g_font.lock);
    if (g_font.face) {
        FT_Done_Face(g_font.face);
        g_font.face = NULL;
    }
    g_font.loaded_file[0] = '\0';
    g_font.loaded_size = 0;
    pthread_mutex_unlock(&g_font.lock);
}

static int font_cache_ensure_locked(const char *font_file, const char *font_path, int px_size) {
    if (!font_file || !*font_file || !font_path || !*font_path) return -1;
    if (px_size < 8) px_size = 8;
    if (px_size > 72) px_size = 72;

    if (g_font.face &&
        strcmp(g_font.loaded_file, font_file) == 0 &&
        g_font.loaded_size == px_size) {
        return 0;
    }

    if (g_font.face) {
        FT_Done_Face(g_font.face);
        g_font.face = NULL;
    }

    if (!g_font.library) {
        if (FT_Init_FreeType(&g_font.library) != 0) {
            g_font.library = NULL;
            return -1;
        }
    }

    if (FT_New_Face(g_font.library, font_path, 0, &g_font.face) != 0) {
        g_font.face = NULL;
        g_font.loaded_file[0] = '\0';
        g_font.loaded_size = 0;
        return -1;
    }

    if (FT_Set_Pixel_Sizes(g_font.face, 0, (FT_UInt)px_size) != 0) {
        FT_Done_Face(g_font.face);
        g_font.face = NULL;
        g_font.loaded_file[0] = '\0';
        g_font.loaded_size = 0;
        return -1;
    }

    safe_str(g_font.loaded_file, sizeof(g_font.loaded_file), font_file);
    g_font.loaded_size = px_size;
    return 0;
}


static int draw_clock_truetype_time_slotted_right_aligned(const char *font_file, int px_size, int hour, int minute, int right_pixel, int show_leading_zero, uint8_t colon_level);
static int clock_colon_blink_phase(void) {
    /* Simple 1-second blink: one second on, one second off. */
    time_t now = time(NULL);
    return (int)(now & 1);
}

static uint8_t clock_colon_blink_level(void) {
    /* Fully visible for one second, fully hidden for one second. */
    return clock_colon_blink_phase() ? 15 : 0;
}

/*
 * Render a TrueType/OpenType clock into a fixed-slot off-screen canvas.
 *
 * Every numeric position uses the widest visible digit from the selected font,
 * so changing minutes cannot move the clock. Glyph bearings, proportional
 * widths, and unusual advance values do not affect the slot origins because
 * placement is based on the bitmap's visible ink rather than its pen metrics.
 *
 * Numeric glyphs are right-anchored inside their fixed slots and the complete
 * slot grid has one fixed screen origin. Minute changes therefore cannot move
 * the clock. The final minute digit reaches right_pixel while the date and
 * music share that same visible-pixel anchor.
 */
static int draw_clock_truetype_time_slotted_right_aligned(const char *font_file, int px_size, int hour, int minute, int right_pixel, int show_leading_zero, uint8_t colon_level) {
    if (!font_file || !*font_file) return -1;

    char font_path[512];
    make_font_path(font_file, font_path, sizeof(font_path));

    pthread_mutex_lock(&g_font.lock);
    if (font_cache_ensure_locked(font_file, font_path, px_size) != 0 || !g_font.face) {
        pthread_mutex_unlock(&g_font.lock);
        return -1;
    }

    FT_Face face = g_font.face;
    int digit_slot = 0;
    int colon_slot = 0;
    int min_y = 99999;
    int max_y = -99999;

    for (char c = '0'; c <= '9'; c++) {
        if (FT_Load_Char(face, c, FT_LOAD_RENDER) != 0) {
            pthread_mutex_unlock(&g_font.lock);
            return -1;
        }

        FT_GlyphSlot glyph = face->glyph;
        int left = ft_bitmap_leftmost_visible_col(&glyph->bitmap);
        int right = ft_bitmap_rightmost_visible_col(&glyph->bitmap);
        if (left < 0 || right < left) {
            pthread_mutex_unlock(&g_font.lock);
            return -1;
        }

        int ink_width = right - left + 1;
        if (ink_width > digit_slot) digit_slot = ink_width;

        int gy1 = glyph->bitmap_top;
        int gy0 = gy1 - (int)glyph->bitmap.rows;
        if (gy0 < min_y) min_y = gy0;
        if (gy1 > max_y) max_y = gy1;
    }

    if (FT_Load_Char(face, ':', FT_LOAD_RENDER) != 0) {
        pthread_mutex_unlock(&g_font.lock);
        return -1;
    }

    {
        FT_GlyphSlot glyph = face->glyph;
        int left = ft_bitmap_leftmost_visible_col(&glyph->bitmap);
        int right = ft_bitmap_rightmost_visible_col(&glyph->bitmap);
        if (left < 0 || right < left) {
            pthread_mutex_unlock(&g_font.lock);
            return -1;
        }

        colon_slot = right - left + 1;
        int gy1 = glyph->bitmap_top;
        int gy0 = gy1 - (int)glyph->bitmap.rows;
        if (gy0 < min_y) min_y = gy0;
        if (gy1 > max_y) max_y = gy1;
    }

    if (digit_slot <= 0 || colon_slot <= 0 || max_y <= min_y) {
        pthread_mutex_unlock(&g_font.lock);
        return -1;
    }

    if (hour < 0) hour = 0;
    else if (hour > 99) hour = 99;
    if (minute < 0) minute = 0;
    else if (minute > 99) minute = 99;

    const int slot_gap = 1;
    int visible_hour_digits = (show_leading_zero || hour >= 10) ? 2 : 1;
    int character_count = visible_hour_digits + 3;
    int total_w = digit_slot * (visible_hour_digits + 2)
        + colon_slot + slot_gap * (character_count - 1);
    if (total_w <= 0 || total_w > OLED_W) {
        pthread_mutex_unlock(&g_font.lock);
        return -1;
    }

    char time_text[8];
    if (visible_hour_digits == 1)
        snprintf(time_text, sizeof(time_text), "%d:%02d", hour, minute);
    else
        snprintf(time_text, sizeof(time_text), "%02d:%02d", hour, minute);

    int text_h = max_y - min_y;
    const int time_band_top = 0;
    const int time_band_bottom = OLED_H - CLOCK_FOOTER_H;
    int top_y = ((OLED_H - text_h) / 2) + CLOCK_TIME_Y_OFFSET;
    if (top_y < time_band_top) top_y = time_band_top;
    if (top_y + text_h > time_band_bottom) top_y = time_band_bottom - text_h;
    if (top_y < 0) top_y = 0;
    int baseline_y = top_y + max_y;

    uint8_t canvas[OLED_W * OLED_H];
    memset(canvas, 0, sizeof(canvas));

    int slot_x = 0;
    for (int i = 0; time_text[i]; i++) {
        char c = time_text[i];
        int slot_w = (c == ':') ? colon_slot : digit_slot;
        if (FT_Load_Char(face, c, FT_LOAD_RENDER) != 0) {
            pthread_mutex_unlock(&g_font.lock);
            return -1;
        }

        FT_GlyphSlot glyph = face->glyph;
        FT_Bitmap *bitmap = &glyph->bitmap;
        int left = ft_bitmap_leftmost_visible_col(bitmap);
        int right = ft_bitmap_rightmost_visible_col(bitmap);
        if (left < 0 || right < left) {
            pthread_mutex_unlock(&g_font.lock);
            return -1;
        }

        int ink_width = right - left + 1;
        /* Numeric glyphs are right-anchored inside fixed-width slots. This
           keeps every slot origin fixed while ensuring the final minute digit
           always reaches the shared visible-pixel anchor. The colon remains
           centred in its own fixed slot. */
        int ink_left = (c == ':')
            ? slot_x + (slot_w - ink_width) / 2
            : slot_x + slot_w - ink_width;
        int bitmap_x = ink_left - left;
        int bitmap_y = baseline_y - glyph->bitmap_top;
        uint8_t foreground = (c == ':') ? colon_level : 15;

        if (foreground > 0) {
            for (unsigned int row = 0; row < bitmap->rows; row++) {
                int y = bitmap_y + (int)row;
                if (y < 0 || y >= OLED_H) continue;

                for (unsigned int col = 0; col < bitmap->width; col++) {
                    int x = bitmap_x + (int)col;
                    if (x < 0 || x >= total_w) continue;

                    uint8_t coverage = ft_bitmap_coverage_at(bitmap, row, col);
                    uint8_t gray = oled_coverage_to_gray4(coverage, foreground);
                    size_t index = (size_t)y * OLED_W + (size_t)x;
                    if (gray > canvas[index]) canvas[index] = gray;
                }
            }
        }

        slot_x += slot_w + slot_gap;
    }

    /* Anchor the fixed slot grid, not the current glyph bounds. The complete
       clock therefore keeps one X origin for every minute value. Because each
       numeric glyph is right-anchored in its slot, the last visible minute
       pixel still lands exactly on right_pixel. */
    int screen_x = right_pixel - (total_w - 1);
    for (int y = time_band_top; y < time_band_bottom; y++) {
        for (int x = 0; x < total_w; x++) {
            uint8_t gray = canvas[(size_t)y * OLED_W + (size_t)x];
            if (gray == 0) continue;

            int destination_x = screen_x + x;
            if (destination_x < 0 || destination_x >= OLED_W) continue;
            if (gray > oled_get_px(destination_x, y))
                oled_set_px(destination_x, y, gray);
        }
    }

    pthread_mutex_unlock(&g_font.lock);
    return 0;
}


static void draw_date_right_aligned_culled(const struct tm *tmv, int min_x, int right_pixel) {
    if (!tmv || right_pixel < min_x) return;

    static const char *days_full[] = {
        "SUNDAY", "MONDAY", "TUESDAY", "WEDNESDAY", "THURSDAY", "FRIDAY", "SATURDAY"
    };
    static const char *days_short[] = {
        "SUN", "MON", "TUE", "WED", "THU", "FRI", "SAT"
    };
    static const char *months_full[] = {
        "JANUARY", "FEBRUARY", "MARCH", "APRIL", "MAY", "JUNE",
        "JULY", "AUGUST", "SEPTEMBER", "OCTOBER", "NOVEMBER", "DECEMBER"
    };
    static const char *months_short[] = {
        "JAN", "FEB", "MAR", "APR", "MAY", "JUN",
        "JUL", "AUG", "SEP", "OCT", "NOV", "DEC"
    };

    int wday = clamp_int(tmv->tm_wday, 0, 6);
    int mon = clamp_int(tmv->tm_mon, 0, 11);
    int day = tmv->tm_mday;
    int year = tmv->tm_year + 1900;

    char candidates[4][96];
    snprintf(candidates[0], sizeof(candidates[0]), "%s, %s %d %04d",
             days_full[wday], months_full[mon], day, year);
    snprintf(candidates[1], sizeof(candidates[1]), "%s, %s %d %04d",
             days_short[wday], months_short[mon], day, year);
    snprintf(candidates[2], sizeof(candidates[2]), "%s %d %04d",
             months_short[mon], day, year);
    snprintf(candidates[3], sizeof(candidates[3]), "%s %d",
             months_short[mon], day);

    int available = right_pixel - min_x + 1;
    for (size_t i = 0; i < sizeof(candidates) / sizeof(candidates[0]); i++) {
        int width = text5x7_ink_width(candidates[i]);
        if (width > 0 && width <= available) {
            draw_text5x7(right_pixel - width + 1, CLOCK_FOOTER_TEXT_Y, 1, candidates[i], 9);
            return;
        }
    }
}


static void draw_clock_footer_contents(const struct tm *tmv,
                                       const char *alarm_label, int alarm_active,
                                       int audio_playing, int show_song_metadata, int story_playing,
                                       const char *audio_display, uint64_t scroll_started_ms) {
    if (tmv) draw_seconds_position_line(tmv->tm_sec);

    int content_min_x = CLOCK_STATUS_TEXT_X;
    if (!story_playing && !audio_playing) {
        safe_str(g_footer_alarm_label, sizeof(g_footer_alarm_label), alarm_label);
        content_min_x = draw_status_labels(g_footer_alarm_label, alarm_active);
    }
    g_footer_content_min_x = content_min_x;

    /* Clock, date, and music share one visible right-edge pixel. */
    if (audio_playing && show_song_metadata && audio_display && audio_display[0])
        draw_song_metadata_line(audio_display, scroll_started_ms,
                                content_min_x, CLOCK_CONTENT_RIGHT_PIXEL);
    else
        draw_date_right_aligned_culled(tmv, content_min_x, CLOCK_CONTENT_RIGHT_PIXEL);
}


static int song_metadata_marquee_active(void) {
    int show;
    int story_playing;
    int audio_playing;
    char audio_display[SONG_METADATA_TEXT_MAX];
    uint64_t now_ms = monotonic_millis();

    pthread_mutex_lock(&g_state.lock);
    show = g_state.show_song_metadata;
    story_playing = g_state.story_playing;
    audio_playing = g_state.audio_playing;
    safe_str(audio_display, sizeof(audio_display), g_state.audio_display);
    if (story_playing) show = now_ms < g_state.story_title_until_ms;
    pthread_mutex_unlock(&g_state.lock);

    if (!audio_playing || !show || !audio_display[0]) return 0;
    int available = CLOCK_CONTENT_RIGHT_PIXEL - g_footer_content_min_x + 1;
    return available > 0 && text5x7_ink_width(audio_display) > available;
}

static void redraw_clock_footer(void) {
    time_t now = time(NULL);
    struct tm tmv;
    localtime_r(&now, &tmv);
    int alarm_active;
    int audio_playing;
    int show_song_metadata;
    int story_playing;
    uint64_t scroll_started_ms;
    char audio_display[SONG_METADATA_TEXT_MAX];

    pthread_mutex_lock(&g_state.lock);
    alarm_active = g_state.alarm_active;
    audio_playing = g_state.audio_playing;
    show_song_metadata = g_state.show_song_metadata;
    story_playing = g_state.story_playing;
    if (story_playing)
        show_song_metadata = monotonic_millis() < g_state.story_title_until_ms;
    scroll_started_ms = g_state.audio_scroll_started_ms;
    safe_str(audio_display, sizeof(audio_display), g_state.audio_display);
    pthread_mutex_unlock(&g_state.lock);

    oled_fill_rect(0, CLOCK_SECONDS_LINE_Y, OLED_W,
                   OLED_H - CLOCK_SECONDS_LINE_Y, 0);
    draw_clock_footer_contents(&tmv, g_footer_alarm_label, alarm_active,
                               audio_playing, show_song_metadata,
                               story_playing, audio_display, scroll_started_ms);
}

static int image_raw_pixel(const uint8_t *raw, int x, int y) {
    if (!raw || x < 0 || y < 0 || x >= MP_IMAGE_WIDTH || y >= MP_IMAGE_HEIGHT) return 0;
    return raw[y * MP_IMAGE_WIDTH + x];
}

static int load_image_raw_uncached_by_file(const char *file, int bedtime, uint8_t *raw, size_t raw_len) {
    if (!raw || raw_len < MP_IMAGE_RAW_BYTES) return -1;
    char path[512];
    if (make_image_path_by_file(file, bedtime, path, sizeof(path)) != 0) return -1;

    struct stat st;
    if (stat(path, &st) != 0 || st.st_size != MP_IMAGE_RAW_BYTES) return -1;
    FILE *f = fopen(path, "rb");
    if (!f) return -1;

    int rc = fread(raw, 1, MP_IMAGE_RAW_BYTES, f) == MP_IMAGE_RAW_BYTES ? 0 : -1;
    if (fclose(f) != 0) rc = -1;
    return rc;
}

static int load_image_raw_cached_by_file(const char *file, int bedtime, uint8_t *raw, size_t raw_len) {
    if (!raw || raw_len < MP_IMAGE_RAW_BYTES || !safe_image_filename(file)) return -1;

    pthread_mutex_lock(&g_image_raw_cache_lock);
    unsigned long generation = g_image_raw_cache.generation;
    if (g_image_raw_cache.valid && g_image_raw_cache.bedtime == bedtime && strcmp(g_image_raw_cache.file, file) == 0) {
        memcpy(raw, g_image_raw_cache.raw, MP_IMAGE_RAW_BYTES);
        pthread_mutex_unlock(&g_image_raw_cache_lock);
        return 0;
    }
    pthread_mutex_unlock(&g_image_raw_cache_lock);

    uint8_t tmp[MP_IMAGE_RAW_BYTES];
    if (load_image_raw_uncached_by_file(file, bedtime, tmp, sizeof(tmp)) != 0) return -1;

    pthread_mutex_lock(&g_image_raw_cache_lock);
    if (g_image_raw_cache.generation == generation) {
        safe_str(g_image_raw_cache.file, sizeof(g_image_raw_cache.file), file);
        g_image_raw_cache.bedtime = bedtime ? 1 : 0;
        memcpy(g_image_raw_cache.raw, tmp, MP_IMAGE_RAW_BYTES);
        g_image_raw_cache.valid = 1;
    }
    pthread_mutex_unlock(&g_image_raw_cache_lock);

    memcpy(raw, tmp, MP_IMAGE_RAW_BYTES);
    return 0;
}

static int collect_image_files(int bedtime, char files[][ASSET_LIST_NAME_MAX], int max_files) {
    return scan_asset_files(image_dir(bedtime), ASSET_LIST_IMAGE_RAW, files, max_files);
}

static int random_image_file(int bedtime, char *out, size_t out_len) {
    char files[ASSET_LIST_MAX_FILES][ASSET_LIST_NAME_MAX];
    int count = collect_image_files(bedtime, files, ASSET_LIST_MAX_FILES);
    if (count <= 0) return -1;
    safe_str(out, out_len, files[rand() % count]);
    return 0;
}

static int sticky_image_file(int bedtime, char *out, size_t out_len) {
    if (!out || out_len == 0) return -1;
    out[0] = '\0';

    time_t now = time(NULL);
    struct rotating_image_state *state = &g_rotating_images[bedtime ? 1 : 0];

    if (state->file[0] && now < state->next_change) {
        uint8_t test[MP_IMAGE_RAW_BYTES];
        if (load_image_raw_cached_by_file(state->file, bedtime, test, sizeof(test)) == 0) {
            safe_str(out, out_len, state->file);
            return 0;
        }
    }

    if (random_image_file(bedtime, state->file, sizeof(state->file)) == 0) {
        state->next_change = now + (bedtime
            ? BEDTIME_IMAGE_CHANGE_SECONDS
            : rand() % (CLOCK_IMAGE_CHANGE_MAX_SECONDS + 1));
        safe_str(out, out_len, state->file);
        return 0;
    }

    state->file[0] = '\0';
    state->next_change = now + 60;
    return -1;
}

static int clock_image_refresh_due(void) {
    int bedtime = is_bedtime_now();
    return time(NULL) >= g_rotating_images[bedtime ? 1 : 0].next_change;
}

static uint8_t image_raw_sample_bilinear(const uint8_t *raw, int x_fp, int y_fp) {
    int x0 = x_fp >> 16;
    int y0 = y_fp >> 16;
    int x1 = x0 + 1;
    int y1 = y0 + 1;
    int wx = x_fp & 0xFFFF;
    int wy = y_fp & 0xFFFF;

    if (x0 < 0) x0 = 0;
    if (y0 < 0) y0 = 0;
    if (x1 >= MP_IMAGE_WIDTH) x1 = MP_IMAGE_WIDTH - 1;
    if (y1 >= MP_IMAGE_HEIGHT) y1 = MP_IMAGE_HEIGHT - 1;

    int p00 = image_raw_pixel(raw, x0, y0);
    int p10 = image_raw_pixel(raw, x1, y0);
    int p01 = image_raw_pixel(raw, x0, y1);
    int p11 = image_raw_pixel(raw, x1, y1);
    int top = p00 * (65536 - wx) + p10 * wx;
    int bottom = p01 * (65536 - wx) + p11 * wx;
    int64_t value = (int64_t)top * (65536 - wy) + (int64_t)bottom * wy;
    return (uint8_t)((value + (1LL << 31)) >> 32);
}

static uint8_t image_gray8_to_oled4(uint8_t gray8, int x, int y) {
    static const uint8_t bayer4[16] = {
         0,  8,  2, 10,
        12,  4, 14,  6,
         3, 11,  1,  9,
        15,  7, 13,  5
    };
    int scaled = (int)gray8 * 15;
    int level = scaled / 255;
    int remainder = scaled - level * 255;
    int threshold = ((int)bayer4[((y & 3) << 2) | (x & 3)] * 255 + 8) / 16;
    if (remainder > threshold && level < 15) level++;
    return (uint8_t)level;
}

static int draw_image_region_raw(const uint8_t *raw, int ox, int oy, int width, int height) {
    if (!raw || width <= 0 || height <= 0) return -1;

    int source_x = 0;
    int source_y = 0;
    int source_width = MP_IMAGE_WIDTH;
    int source_height = MP_IMAGE_HEIGHT;

    /* Fill the destination without distortion. Crop centrally to its final
       aspect ratio, then resize the 8-bit source and quantize exactly once. */
    if ((long long)source_width * height > (long long)source_height * width) {
        source_width = (source_height * width) / height;
        if (source_width < 1) source_width = 1;
        source_x = (MP_IMAGE_WIDTH - source_width) / 2;
    } else if ((long long)source_width * height < (long long)source_height * width) {
        source_height = (source_width * height) / width;
        if (source_height < 1) source_height = 1;
        source_y = (MP_IMAGE_HEIGHT - source_height) / 2;
    }

    for (int y = 0; y < height; y++) {
        int64_t sy_fp = ((int64_t)(2 * y + 1) * source_height * 65536) /
                        (2 * height) - 32768 + ((int64_t)source_y << 16);
        if (sy_fp < ((int64_t)source_y << 16)) sy_fp = (int64_t)source_y << 16;
        int64_t sy_max = (int64_t)(source_y + source_height - 1) << 16;
        if (sy_fp > sy_max) sy_fp = sy_max;

        for (int x = 0; x < width; x++) {
            int64_t sx_fp = ((int64_t)(2 * x + 1) * source_width * 65536) /
                            (2 * width) - 32768 + ((int64_t)source_x << 16);
            if (sx_fp < ((int64_t)source_x << 16)) sx_fp = (int64_t)source_x << 16;
            int64_t sx_max = (int64_t)(source_x + source_width - 1) << 16;
            if (sx_fp > sx_max) sx_fp = sx_max;

            uint8_t gray8 = image_raw_sample_bilinear(raw, (int)sx_fp, (int)sy_fp);
            oled_set_px(ox + x, oy + y, image_gray8_to_oled4(gray8, ox + x, oy + y));
        }
    }

    return 0;
}

static int draw_image_region_by_file(const char *file, int bedtime,
                                     int ox, int oy, int width, int height) {
    uint8_t raw[MP_IMAGE_RAW_BYTES];
    if (load_image_raw_cached_by_file(file, bedtime, raw, sizeof(raw)) != 0) return -1;
    return draw_image_region_raw(raw, ox, oy, width, height);
}

static int draw_image_thumb_by_file(const char *file, int bedtime, int ox, int oy, int size) {
    return draw_image_region_by_file(file, bedtime, ox, oy, size, size);
}

static void refresh_story_collage(void) {
    char files[ASSET_LIST_MAX_FILES][ASSET_LIST_NAME_MAX];
    int count = collect_image_files(1, files, ASSET_LIST_MAX_FILES);
    memset(&g_story_collage, 0, sizeof(g_story_collage));
    if (count <= 0) return;

    int indices[ASSET_LIST_MAX_FILES];
    for (int i = 0; i < count; i++) indices[i] = i;
    for (int i = count - 1; i > 0; i--) {
        int j = rand() % (i + 1);
        int tmp = indices[i];
        indices[i] = indices[j];
        indices[j] = tmp;
    }

    g_story_collage.count = count < STORY_COLLAGE_MAX_IMAGES ? count : STORY_COLLAGE_MAX_IMAGES;
    for (int i = 0; i < g_story_collage.count; i++)
        safe_str(g_story_collage.files[i], sizeof(g_story_collage.files[i]), files[indices[i]]);
}

static int story_display_phase(void) {
    uint64_t now_ms = monotonic_millis();
    int phase = 0;
    pthread_mutex_lock(&g_state.lock);
    /* Keep the Story Mode intro visible for its full window even if the
       audio thread exits very quickly during startup. Without this, a failed
       or fast audio startup can make the OLED/browser preview look like it
       only flashed instead of showing the configured intro message. */
    if (now_ms < g_state.story_intro_until_ms) phase = 1;
    else if (g_state.story_playing && now_ms < g_state.story_title_until_ms) phase = 2;
    pthread_mutex_unlock(&g_state.lock);
    return phase;
}

static int story_touch_input_locked(uint64_t now_ms) {
    int locked;
    pthread_mutex_lock(&g_state.lock);
    locked = g_state.story_playing && now_ms < g_state.story_title_until_ms;
    pthread_mutex_unlock(&g_state.lock);
    return locked;
}
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
int main(void) {
    g_start_time = time(NULL);

    if (mpg123_init() != MPG123_OK) {
        fprintf(stderr, "mpg123_init failed\n");
        return 1;
    }

    signal(SIGINT, on_signal);
    signal(SIGTERM, on_signal);
    srand((unsigned int)(time(NULL) ^ getpid()));

    ensure_dir(APP_ROOT);
    ensure_dir(IMAGE_DIR);
    ensure_dir(BEDTIME_IMAGE_DIR);
    ensure_dir(MUSIC_DIR);
    ensure_dir(STORY_DIR);
    ensure_dir(FONT_DIR);
    ensure_dir(CONFIG_DIR);
    init_alarm_defaults();
    load_config();
    int alarm_history_migrated = migrate_alarm_last_fired_dates();
    int default_font_applied = apply_default_font_selection();
    if (default_font_applied || alarm_history_migrated) {
        save_config();
        if (default_font_applied)
            app_log("display", "Applied the default clock font selection");
        if (alarm_history_migrated)
            app_log("alarm", "Migrated the last alarm occurrence into persistent replay protection");
    }
    app_log("system", "mk-piclock %s starting on %s", APP_VERSION, MP_PLATFORM_PROFILE);

    int touch_available = (touch_init() == 0);
    if (touch_available) app_log("system", "TTP223B touch input initialized on GPIO %d", GPIO_TOUCH);
    else app_log("system", "TTP223B touch input unavailable on GPIO %d", GPIO_TOUCH);

    int led_available = (mp_led_init() == 0);
    if (led_available)
        app_log("system", "Common-cathode RGB LED initialized on GPIO %d/%d/%d",
                MP_LED_GPIO_RED, MP_LED_GPIO_GREEN, MP_LED_GPIO_BLUE);
    else
        app_log("system", "RGB LED unavailable on GPIO %d/%d/%d",
                MP_LED_GPIO_RED, MP_LED_GPIO_GREEN, MP_LED_GPIO_BLUE);
    update_led_scene();

    if (oled_init() == 0) {
        pthread_mutex_lock(&g_state.lock);
        g_state.oled_ok = 1;
        pthread_mutex_unlock(&g_state.lock);
        app_log("system", "OLED initialized");
        apply_bedtime_brightness();
        draw_startup_screen();
        sleep(STARTUP_GREETING_SECONDS);
        draw_clock_screen();
    } else {
        app_log("system", "OLED init failed, core IPC will still start");
        fprintf(stderr, "OLED init failed, core IPC will still start\n");
    }

    pthread_t ipc_thread;
    pthread_t touch_thread;
    int touch_thread_started = 0;
    app_log("system", "Private core IPC listening on %s", CORE_SOCKET_PATH);

    if (touch_available) {
        if (pthread_create(&touch_thread, NULL, touch_thread_main, NULL) == 0) {
            touch_thread_started = 1;
        } else {
            app_log("system", "Unable to start touch input thread");
            touch_close();
        }
    }

    if (pthread_create(&ipc_thread, NULL, ipc_thread_main, NULL) != 0) {
        perror("pthread_create");
        return 1;
    }

    int last_min = -1;
    int last_sec = -1;
    int last_mode = -1;
    int last_colon_phase = -1;
    int last_story_phase = -1;
    uint64_t last_diagnostic_refresh_ms = 0;
    while (g_running) {
        check_alarm();
        activate_pending_message_if_due();
        apply_bedtime_brightness();
        enforce_bedtime_music_policy();
        update_led_scene();

        pthread_mutex_lock(&g_state.lock);
        int mode = g_state.display_mode;
        int dirty = g_state.display_dirty;
        g_state.display_dirty = 0;
        int oled_ok = g_state.oled_ok;
        pthread_mutex_unlock(&g_state.lock);

        int marquee_active = 0;
        if (oled_ok) {
            if (mode == 2) {
                time_t until;
                char msg_image_file[IMAGE_FILE_MAX];
                int msg_image_bedtime;
                char msg_text[192];
                pthread_mutex_lock(&g_state.lock);
                until = g_state.message_until;
                safe_str(msg_image_file, sizeof(msg_image_file), g_state.message_image_file);
                msg_image_bedtime = g_state.message_image_bedtime;
                safe_str(msg_text, sizeof(msg_text), g_state.message_text);
                pthread_mutex_unlock(&g_state.lock);

                if (time(NULL) >= until) {
                    pthread_mutex_lock(&g_state.lock);
                    g_state.display_mode = 0;
                    g_state.message_until = 0;
                    pthread_mutex_unlock(&g_state.lock);
                    mode = 0;
                    last_mode = -1;
                } else if (dirty || mode != last_mode) {
                    draw_message_screen_file(msg_image_file, msg_image_bedtime, msg_text);
                }
            }

            if (mode == 3) {
                time_t diagnostic_until;
                pthread_mutex_lock(&g_state.lock);
                diagnostic_until = g_state.diagnostic_until;
                pthread_mutex_unlock(&g_state.lock);
                if (diagnostic_until <= 0 || time(NULL) >= diagnostic_until) {
                    close_diagnostic_screen();
                    pthread_mutex_lock(&g_state.lock);
                    mode = g_state.display_mode;
                    pthread_mutex_unlock(&g_state.lock);
                    last_mode = -1;
                } else {
                    uint64_t diagnostic_now_ms = monotonic_millis();
                    if (dirty || mode != last_mode ||
                        diagnostic_now_ms - last_diagnostic_refresh_ms >= DIAGNOSTIC_REFRESH_MS) {
                        draw_diagnostic_screen();
                        last_diagnostic_refresh_ms = diagnostic_now_ms;
                    }
                }
            }

            if (mode == 0) {
                time_t now = time(NULL);
                struct tm tmv;
                localtime_r(&now, &tmv);
                int colon_phase = clock_colon_blink_phase();
                int story_phase = story_display_phase();
                marquee_active = song_metadata_marquee_active();
                int full_clock_redraw = dirty || mode != last_mode ||
                    tmv.tm_min != last_min || story_phase != last_story_phase ||
                    clock_image_refresh_due();
                int second_tick = story_phase == 0 &&
                    (tmv.tm_sec != last_sec || colon_phase != last_colon_phase);

                if (full_clock_redraw) {
                    last_min = tmv.tm_min;
                    last_sec = tmv.tm_sec;
                    last_colon_phase = colon_phase;
                    last_story_phase = story_phase;
                    draw_clock_screen();
                } else {
                    int framebuffer_changed = 0;

                    if (second_tick) {
                        last_sec = tmv.tm_sec;
                        last_colon_phase = colon_phase;
                        if (update_clock_second_tick(tmv.tm_sec, colon_phase) == 0) {
                            framebuffer_changed = 1;
                        } else {
                            last_min = tmv.tm_min;
                            last_story_phase = story_phase;
                            draw_clock_screen();
                        }
                    }

                    if (marquee_active) {
                        redraw_clock_footer();
                        framebuffer_changed = 1;
                    }

                    if (framebuffer_changed) (void)oled_flush();
                }
            } else if (mode == 1) {
                if (dirty || mode != last_mode) {
                    oled_clear_fb(0);
                    oled_flush_full();
                }
            }
        }

        last_mode = mode;
        usleep(marquee_active ? SONG_SCROLL_FRAME_US : 250000u);
    }

    if (touch_thread_started) pthread_join(touch_thread, NULL);
    touch_close();
    (void)audio_force_stop_and_wait(3000u);
    mp_led_shutdown();
    pthread_mutex_lock(&g_font.lock);
    font_cache_close_locked();
    pthread_mutex_unlock(&g_font.lock);
    oled_close();
    mpg123_exit();
    return 0;
}
