mkinderwater/mk-piclock-kid/hardware_profile.h

#ifndef MK_PICLOCK_HARDWARE_PROFILE_H
#define MK_PICLOCK_HARDWARE_PROFILE_H

/*
 * mk-piclock hardware identity for Raspberry Pi Zero W and Zero 2 W.
 *
 * The product string is used by the startup greeting, API, diagnostics,
 * logs, and web interface so platform builds identify themselves consistently.
 */
#define MP_PLATFORM_PROFILE "Raspberry Pi Zero W / Zero 2 W"
#define MP_PRODUCT_VERSION "1.9.17-rpi-zero-r3"

#endif
