mkinderwater/mk-piclock-kid/(commit log)

2026-07-27 sample images for kid clock
    girl sample images for kid clock
2026-08-06 improved fdm print / added mirror layout.
    [mk-piclock-kids-v3_47-recess-roof-fix-6.scad]
